jonacappelle/Embedded-Systems-II-Lab/README.md

# LAB: Embedded Systems II

## SOFTWARE

- [IMU](https://github.com/jonacappelle/Embedded-Systems-II-Lab/tree/master/Jona%20-%20IMU%20and%20Main%20PCB/Embedded_II_ICM_20948)
- [Game](https://github.com/jonacappelle/Embedded-Systems-II-Lab/tree/master/Niels%20-%20Code%20spel/SLSTK3400A_blink)
- [LoRa](https://github.com/jonacappelle/Embedded-Systems-II-Lab/tree/master/Pieter%20-%20Connectivity%20and%20Visualisation)

## HARDWARE

[Main board](https://github.com/jonacappelle/Embedded-Systems-II-Lab/tree/master/Jona%20-%20IMU%20and%20Main%20PCB/EFM32_ICM20948_PCB)  
[Energy harvesting](https://github.com/jonacappelle/Embedded-Systems-II-Lab/tree/master/Daan%20-%20VoedingDesign%20PCB/schema_pcb)

### MAIN BOARD: µC + Compass + LoRa

<p align="center">
  
</p>
<p align="center">
  
</p>

### POWER BOARD

<p align="center">
  
</p>
<p align="center">
  
</p>
