jonacappelle/Embedded-Systems-II-Lab/Daan - VoedingDesign PCB/EnergieBerekeningen.xlsx

Berekening voor 3 uur actief per dag |  |  | Bij zenden
 | IMU | LDO (IMU) | RFID (zenden) | LoRa (zenden) | EFM32 | 2x 7-segment displays | 4x Backlight LED's | Verliezen bij andere componenten
Stroomverbruik (mA) | 3.11 | 0.001 | 20 | 38.9 | 3.5 | 2 x 7 x 20 mA = 280 mA | 4 x 20 mA | 15
Werkspanning (V) | 1.8 | 1.5 | 3.3 | 3.3 | 3.3 | 2 | 3 | 3.3 |  | Veronderstellingen voor 3 uur spel per dag:
Vermogen verbruik (mW) | 5.598 | 0.0015 | 66 | 128.37 | 11.55 | 560 | 4 x 60 mW | 50 |  | 30 spelletjes in 3 uur gespeeld: 6 min per spel inclusief aanmelden
Tijd actief per dag (uur) | 3 | 3 | 30x0,033 | 0.000277 | 3 | 0.17 | 2.5 | 3 |  | 2x highscore in top drie verbroken per 3u --> tijd om te zenden 5 min per highscore
Tijd actief per dag (seconden) | 10800 | 10800 | 3600 | 1 | 10800 | 600 | 9000 | 10800 |  | 7 segment display 30 x 20 seconden aan op flikker (om de seconde flikkeren) stand (5 seconden aan om duidelijk te maken dat kaart gelezen moeten worden, 5 seconden aan voor score)
Energie verbruik (J) | 60.458 | 0.016 | 237.600 | 0.128 | 124.740 | 336.000 | 540.000 | 540.000 |  | gedurende de spel tijd (2,5 u): slechts 1 backlight per keer aan
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
