jonacappelle/Embedded-Systems-II-Lab/Daan - VoedingDesign PCB/aanwezigeComponentenOpSchool/90715364_145681366821309_824279871361384448_n.png

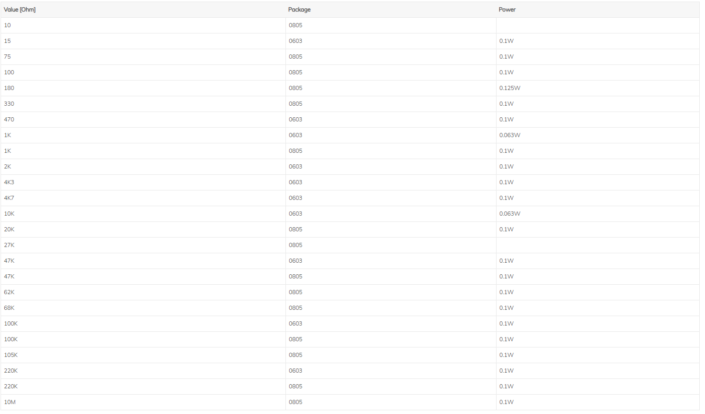
Daan - VoedingDesign PCB/aanwezigeComponentenOpSchool/90715364_145681366821309_824279871361384448_n.png
