jonacappelle/Embedded-Systems-II-Lab/Daan - VoedingDesign PCB/aanwezigeComponentenOpSchool/90789569_214061636350394_7333743442029182976_n.png

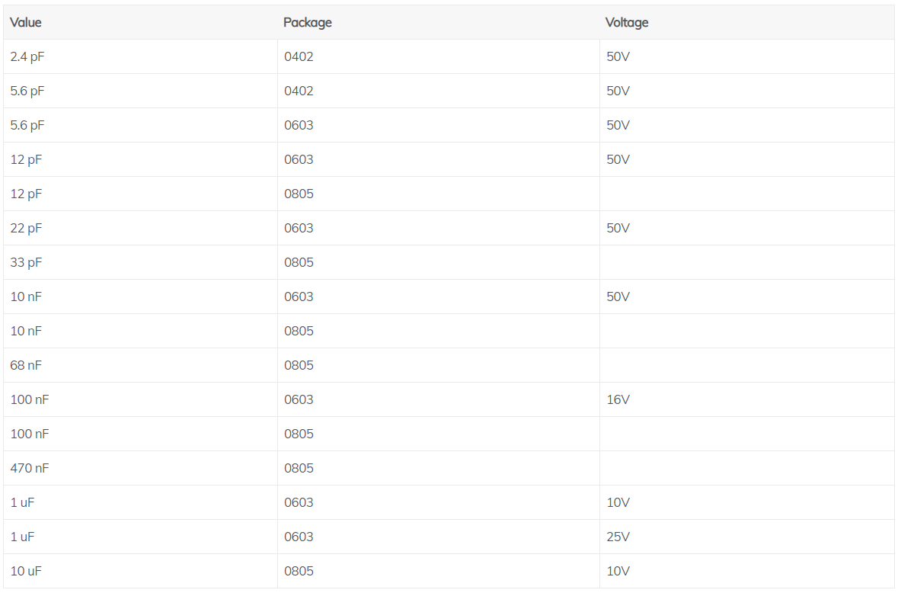
Daan - VoedingDesign PCB/aanwezigeComponentenOpSchool/90789569_214061636350394_7333743442029182976_n.png
