jonacappelle/Embedded-Systems-II-Lab/Info/Main_PCB/Embedded_II_MAIN_BOARD_BOM.txt

------------------------------------------------
Team Turn Table BOM Main PCB: Kompas + uC + LoRa
------------------------------------------------
Dit is het minimaal aantal nodige componenten.
Best enkele extras voorzien a.u.b.
------------------------------------------------

Qty Value                   Device                     Package                    Parts                                                                               Description                                                                                                                     DESCRIPTION                                                                                                                     HEIGHT MANUFACTURER_NAME MANUFACTURER_PART_NUMBER MOUSER_PART_NUMBER   MOUSER_PRICE-STOCK                                                     PROD_ID     SPICEPREFIX TP_SIGNAL_NAME VALUE                  

-------------
 Capacitors
-------------
Op de campus:
9   100n                    CAP_CERAMIC0603            0603                       C22, C23, C26, C27, C28, C29, C33, C3, C7                                           Ceramic Capacitors                                                                                                                                                                                                                                                                                                                                                                                                                                                          
2   10n                     CAP_CERAMIC0603            0603                       C30, C31                                                                            Ceramic Capacitors                                                                                                                                                                                                                                                                                                                                                                                                                                                          
2   10u                     C-EUC0805K                 C0805K                     C2, C6                                                                              CAPACITOR, European symbol                                                                                                                                                                                                                                                                                                                                                                                                C                                                 
3   10u                     CAP_CERAMIC0603            0603                       C1, C24, C25                                                                        Ceramic Capacitors                                                                                                                                                                                                                                                                                                                                                                                                                                                          
2   12p                     CAP_CERAMIC0603            0603                       C36, C37                                                                            Ceramic Capacitors                                                                                                                                                                                                                                                                                                                                                                                                                                                          
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
1   1                       RESISTOR0603               0603                       R34                                                                                 Resistors                                                                                                                                                                                                                                                                                                                                                                                                                                                                   
1   100                     RESISTOR0603               0603                       R33                                                                                 Resistors                                                                                                                                                                                                                                                                                                                                                                                                                                                                   
1   1Meg                    RESISTOR0603               0603                       R6                                                                                  Resistors                                                                                                                                                                                                                                                                                                                                                                                                                                                                   

Bestellen:
1   12Meg                   RESISTOR0603               0603                       R29                                                                                 Resistors                                                                                                                                                                                                                                                                                                                                                                                                                                                                   
https://www.mouser.be/ProductDetail/Yageo/AF0603JR-0712ML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

----------------
Microcontroller
----------------
1   IC2                     EFM32HG322F64G-C -QFP48R 
https://www.mouser.be/ProductDetail/Silicon-Labs/EFM32HG322F64G-C-QFP48R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

----------
 Mosfets
----------
3   20V/0.2A/8MHz/1.2Ω/1Vth MOSFET-NCH-RE1C002UN       SOT-416FL                  Q1, Q6, Q8                                                                          N-channel MOSFETs                                                                                                                                                                                                                                                                                                                                                                                             TRANS_14399                            20V/0.2A/8MHz/1.2Ω/1Vth
https://www.mouser.be/ProductDetail/ROHM-Semiconductor/RE1C002UNTCL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

-----------
 Kompas + accelerometer
-----------
1	ICM20948
https://www.mouser.be/ProductDetail/TDK-InvenSense/ICM-20948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

----------
 Ferriet
----------
1   74279266                74279266                   BEADC1608X100N             FB1                                                                                 WE-CBF Ferrite Bead 0603 1000Ohm 200mA Wurth WE-CBF Series +/-25% Ferrite Multilayer SMD Inductor, 0603 Case, 200mA dc 600m Rdc WE-CBF Ferrite Bead 0603 1000Ohm 200mA Wurth WE-CBF Series +/-25% Ferrite Multilayer SMD Inductor, 0603 Case, 200mA dc 600m Rdc 1mm    Wurth Elektronik  74279266                 710-74279266         https://www.mouser.com/Search/Refine.aspx?Keyword=710-74279266                                                                       
https://www.mouser.be/ProductDetail/Wurth-Elektronik/74279266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

----------
 Crystals
----------
1   FC-135_32.7680KA-A3     FC-135_32.7680KA-A3        FC135327680KAAG0           Y2                                                                                  Crystals 32.768KHz 20ppm 12.5pF -40C -85C                                                                                       Crystals 32.768KHz 20ppm 12.5pF -40C -85C                                                                                       0mm    Epson Timing      FC-135 32.7680KA-A3      732-FC135-32.76KAA3  https://www.mouser.com/Search/Refine.aspx?Keyword=732-FC135-32.76KAA3                                                                
1   ABM3B-24.000MHZ-B2-T    ABM3B-24.000MHZ-B2-T       ABM3B8000MHZ101UT          Y3                                                                                  Abracon 24MHz Crystal +/-20ppm SMD 5 x 3 x 1.1mm                                                                                Abracon 24MHz Crystal +/-20ppm SMD 5 x 3 x 1.1mm                                                                                1.1mm  ABRACON           ABM3B-24.000MHZ-B2-T     815-ABM3B-24-B2      https://www.mouser.com/Search/Refine.aspx?Keyword=815-ABM3B-24-B2                                                                    
https://www.mouser.be/ProductDetail/ABRACON/ABM3B-24000MHZ-B2-T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
https://www.mouser.be/ProductDetail/Epson-Timing/FC-135-327680KA-A3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

---------
 Button
---------
1   PTS815_SJK_250_SMTR_LFS PTS815_SJK_250_SMTR_LFS    PTS815SJK250SMTRLFS        S1                                                                                  Tactile Switches Tact Switch, 12 VDC, 50 mA, 4.2x3.2, 2.5mm H, 250gf, J leads                                                   Tactile Switches Tact Switch, 12 VDC, 50 mA, 4.2x3.2, 2.5mm H, 250gf, J leads                                                   2mm    C & K COMPONENTS  PTS815 SJK 250 SMTR LFS  611-PTS815SJK250SMTR https://www.mouser.com/Search/Refine.aspx?Keyword=611-PTS815SJK250SMTR                                                               
https://www.mouser.be/ProductDetail/CK/PTS815-SJK-250-SMTR-LFS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

---------
 LDO
---------
1   TPS7A0518PDBZR          TPS7A0518PDBZR             SOT95P237X112-3N           IC5                                                                                 1-A, ultra-low-IQ, 200-mA low-dropout (LDO) regulator in a small-sized package                                                  1-A, ultra-low-IQ, 200-mA low-dropout (LDO) regulator in a small-sized package                                                  1.12mm Texas Instruments TPS7A0518PDBZR           595-TPS7A0518PDBZR   https://www.mouser.com/Search/Refine.aspx?Keyword=595-TPS7A0518PDBZR                                                                 
https://www.mouser.be/ProductDetail/Texas-Instruments/TPS7A0518PDBZR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

--------
 Led
--------
1   Green/Blue              LED0805                    CHIPLED_0805               PWR_LED                                                                             LED                                                                                                                                                                                                                                                                                                                                                                                                                                                                         

--------
 LoRa
--------
Waarschijnlijk op de campus?
1   RN2483 LoRa module	
1   ANTENNA868              ANTENNA868                 CERAMIC-ANTENNA            U$2                                                                                                                                                                                                                                                                                                                                                                                                                                                                                                                                                             
1   WE-MK_0603_744786118    WE-MK_0603_744786118       WE-MK_0603                 L1                                                                                                                                                                                                                                                                                                                                                                                                                                                                                                                                                              
2   Caps bij LoRa module    C-EUC0603K                 C0603K                     C4, C5                                                                              CAPACITOR, European symbol
