jonacappelle/Embedded-Systems-II-Lab/Info/Main_PCB/Embedded_II_MAIN_BOARD.pdf

# IMU

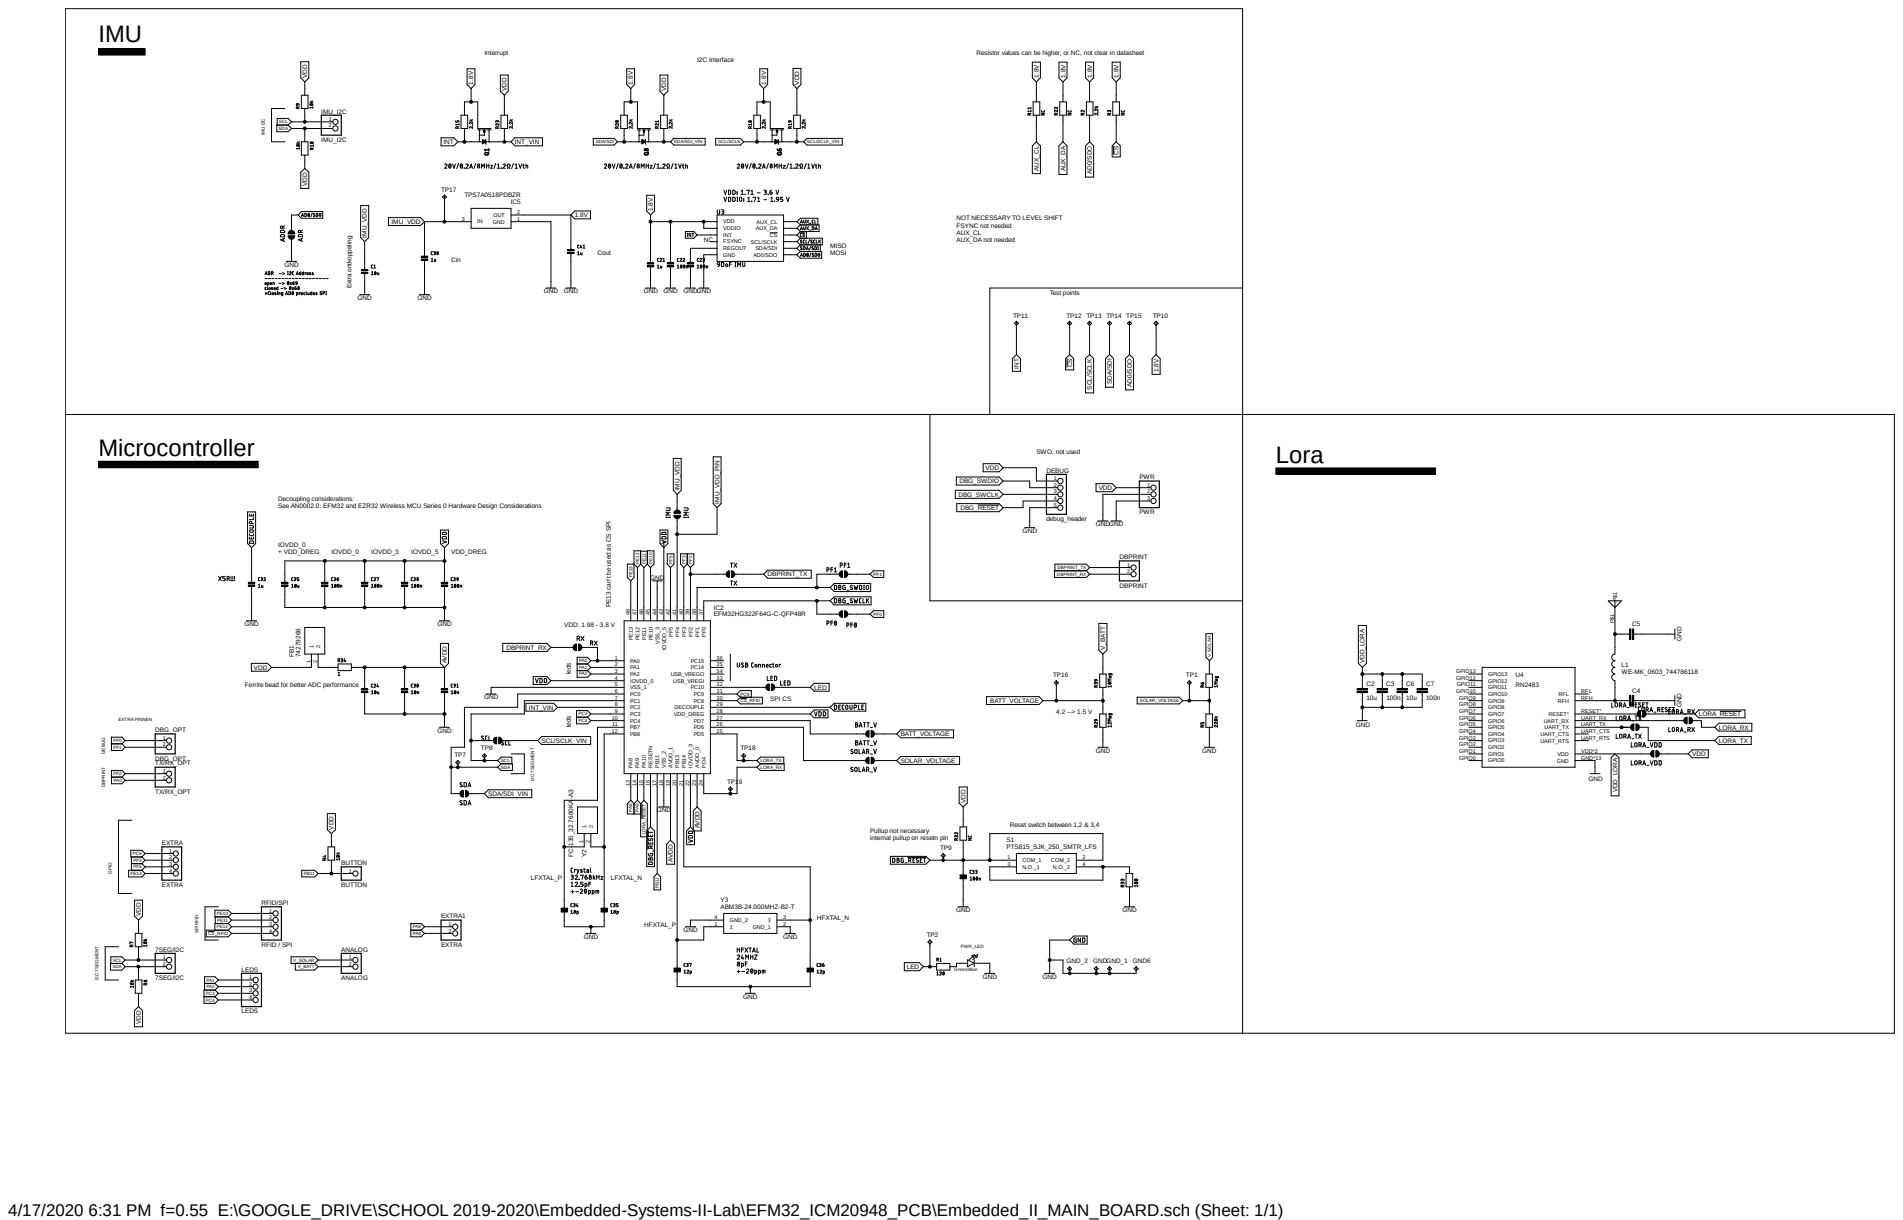
[picture p68: page 1]

Resistor values can be higher, or NC, not clear in datasheet

NOT NECESSARY TO LEVEL SHIFT
FSYNC not needed
AUX_CL

CoutPE¹³ can't be used as CS SPI

VDD VDD

Decoupling considerations:
See AN0002.0: EFM32 and EZR32 Wireless MCU Series 0 Hardware Design Considerations

Ferrite bead for better ADC performance

Pullup not necessary
internal pullup on resetn pin

4/17/2020 6:31 PM f=0.55 E:\GOOGLE_DRIVE\SCHOOL 2019-2020\Embedded-Systems-II-Lab\EFM32_ICM20948_PCB\Embedded_II_MAIN_BOARD.sch (Sheet: 1/1)
