jonacappelle/Embedded-Systems-II-Lab/Pieter - Connectivity and Visualisation/LoRaWAN_EFM32-master_DRAMCO/DOC/Eagle/v4.0.pdf

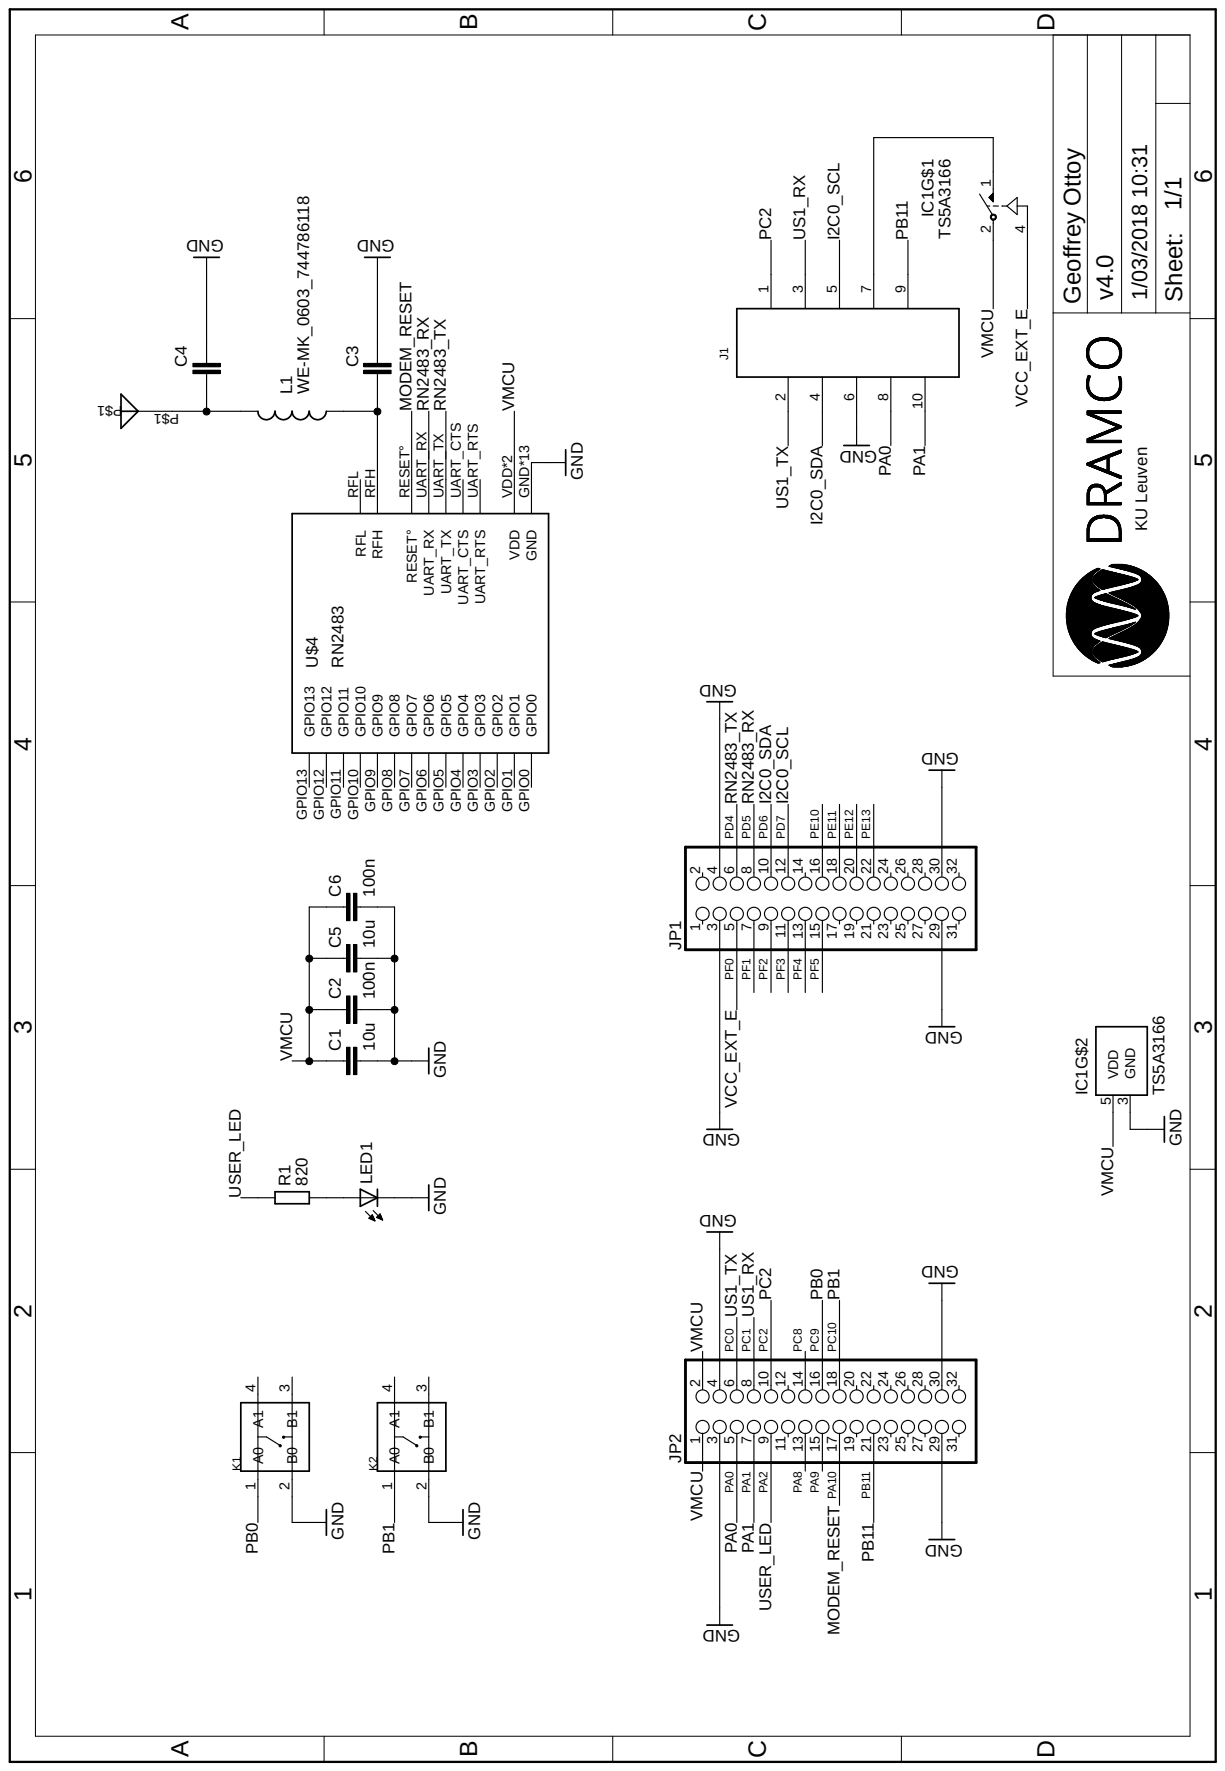
[picture p69: page 1]

P$1 P$1 L1 C5 C6 IC1G$1 4 1 2 IC1G$2 GND 3 VDD 5 VMCU VMCU VMCU VMCU VMCU VMCU PC0 PC1 PC2 PC2 PC8 PC9 PC10 PA0 PA0 PA1 PA1 PA2 PA8 PA9 PA10 PB11 PB11 PD4 PD5 PD6 PD7 PE10 PE11 PE12 PE13 PF0 PF1 PF2 PF3 PF4 PF5 v4.0 1/03/2018 10:31 1/1 Sheet: ABCD 1 2 3 4 5 6 ABCD 1 2 3 4 5 6

Geoffrey Ottoy KU Leuven 10u 100n GND RN2483 GND

GND GND WE-MK_0603_744786118 10u 100n TS5A3166 TS5A3166 GND I2C0_SDA I2C0_SCL PC2 PB0 PB1 PA0 PA1 PB11 MODEM_RESET RN2483_RX RN2483_TX RN2483_TX RN2483_RX MODEM_RESET I2C0_SCL I2C0_SDA US1_TX US1_RX US1_TX US1_RX PB0 PB1 USER_LED USER_LED VCC_EXT_E VCC_EXT_E C1 C2 GND GND*13 UART_TX UART_TX UART_RX UART_RX VDD VDD*2 RFH RFH RFL RFL RESET° RESET° U$4 UART_CTS UART_CTS UART_RTS UART_RTS GPIO0 GPIO0 GPIO1 GPIO1 GPIO2 GPIO2 GPIO3 GPIO3 GPIO4 GPIO4 GPIO5 GPIO5 GPIO6 GPIO6 GPIO7 GPIO7 GPIO8 GPIO8 GPIO9 GPIO9 GPIO10 GPIO10 GPIO11 GPIO11 GPIO12 GPIO12 GPIO13 GPIO13 JP21 2 3 4 5 6 7 8 9 10 11 12 13 14 15 16 17 18 19 20 21 22 23 24 25 26 27 28 29 30 31 32 JP11 2 3 4 5 6 7 8 9 10 11 12 13 14 15 16 17 18 19 20 21 22 23 24 25 26 27 28 29 30 31 32 J1 10 9 8 7 6 5 4 3 2 1 K1A0 1 A1 4 B0 2 B1 3 K2A0 1 A1 4 B0 2 B1 3 R1LED1 C4 C3

GND GND GND 820 GND
