jonacappelle/Embedded-Systems-II-Lab/Daan - VoedingDesign PCB/schema_pcb/EnergyHarvestingBestukking.pdf

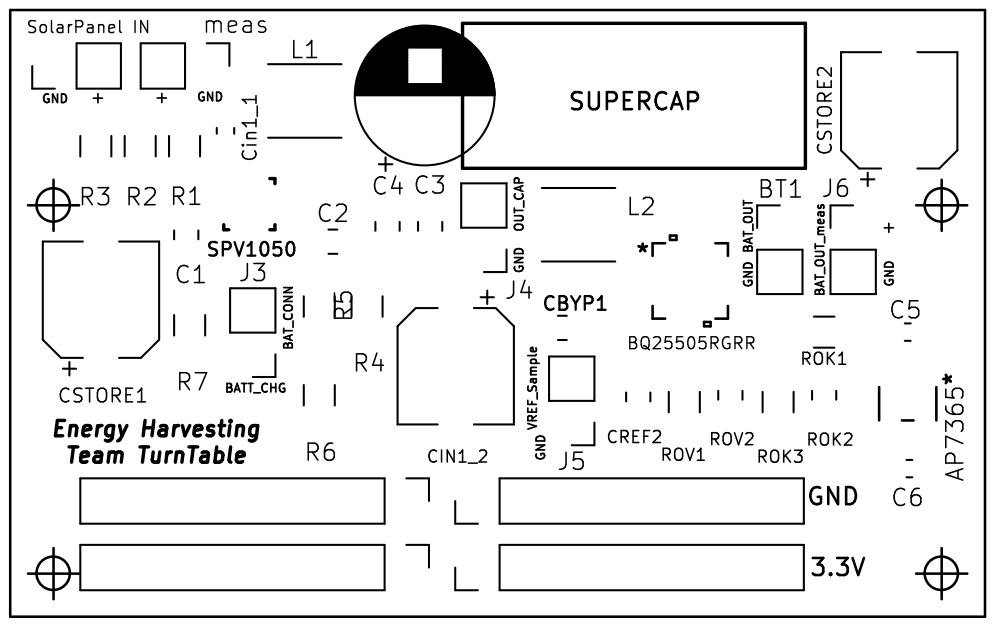
[picture p70: page 1]

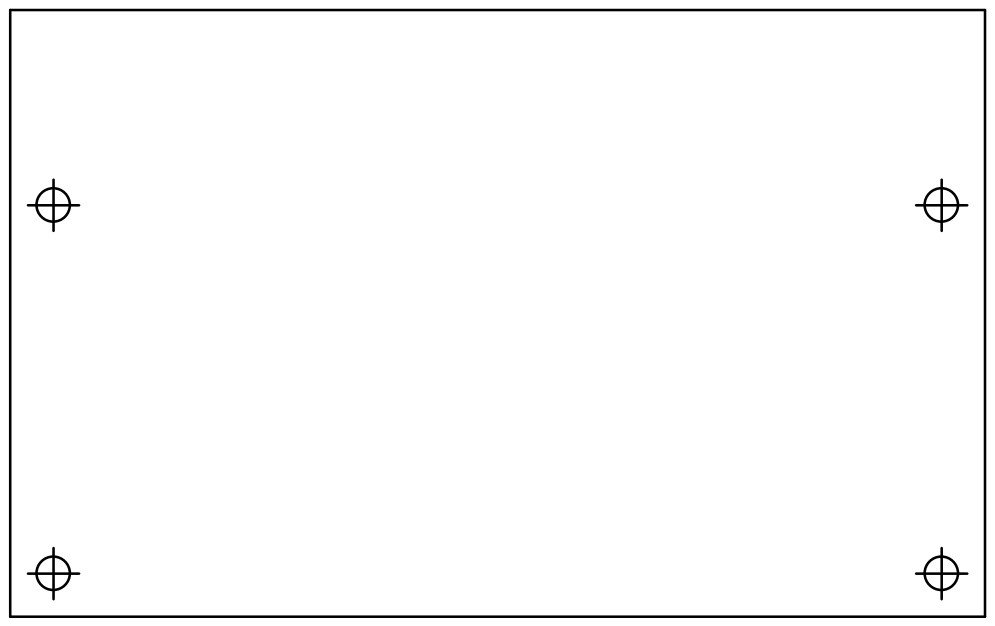
[picture p71: page 2]

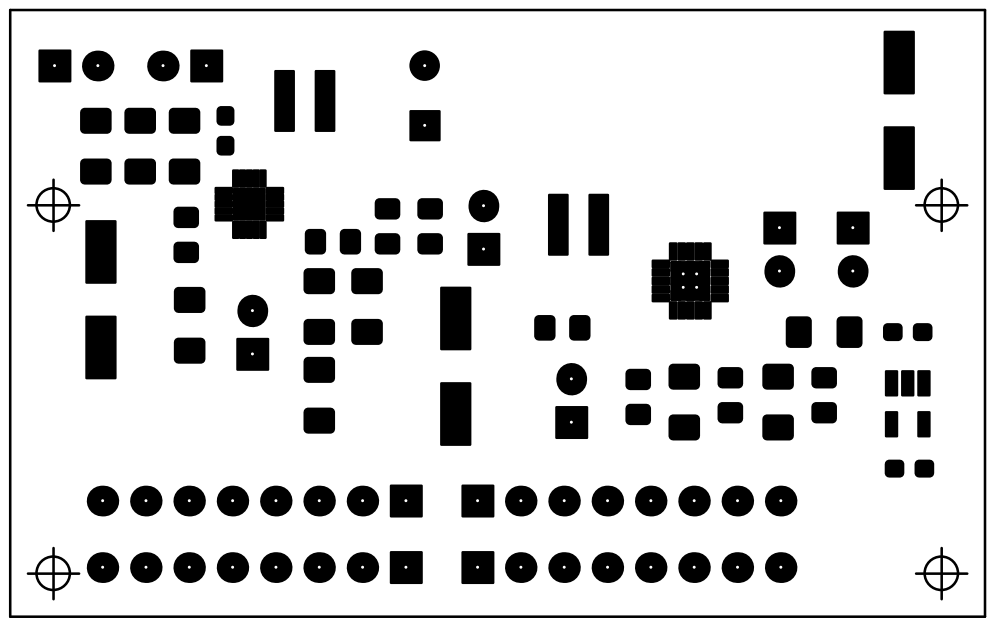
[picture p72: page 3]

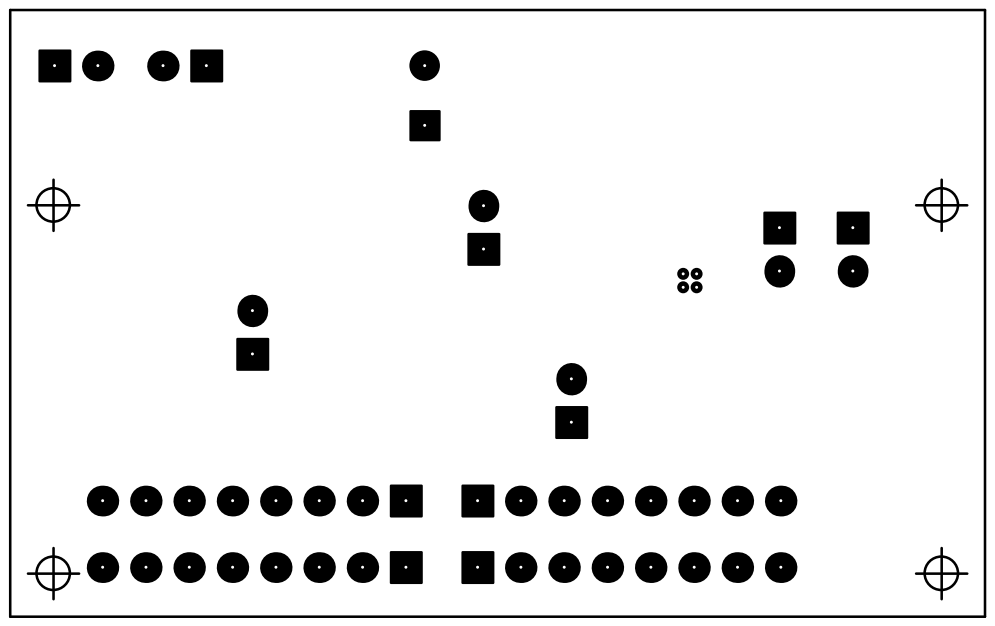
[picture p73: page 4]
