jonacappelle/Embedded-Systems-II-Lab/Daan - VoedingDesign PCB/schema_pcb/BestukkingInfo/EnergyHarvestingPCB/BestukkingEnergyHarvesting.pdf

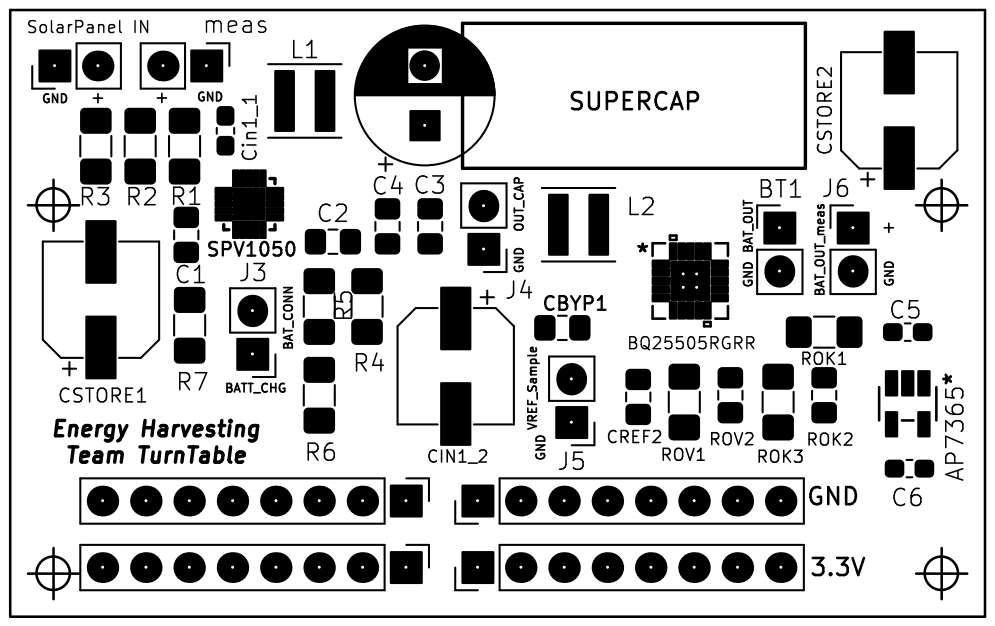
[picture p74: page 1]
