jonacappelle/Embedded-Systems-II-Lab/Info/EnergyHarvestingPCB/Schema.pdf

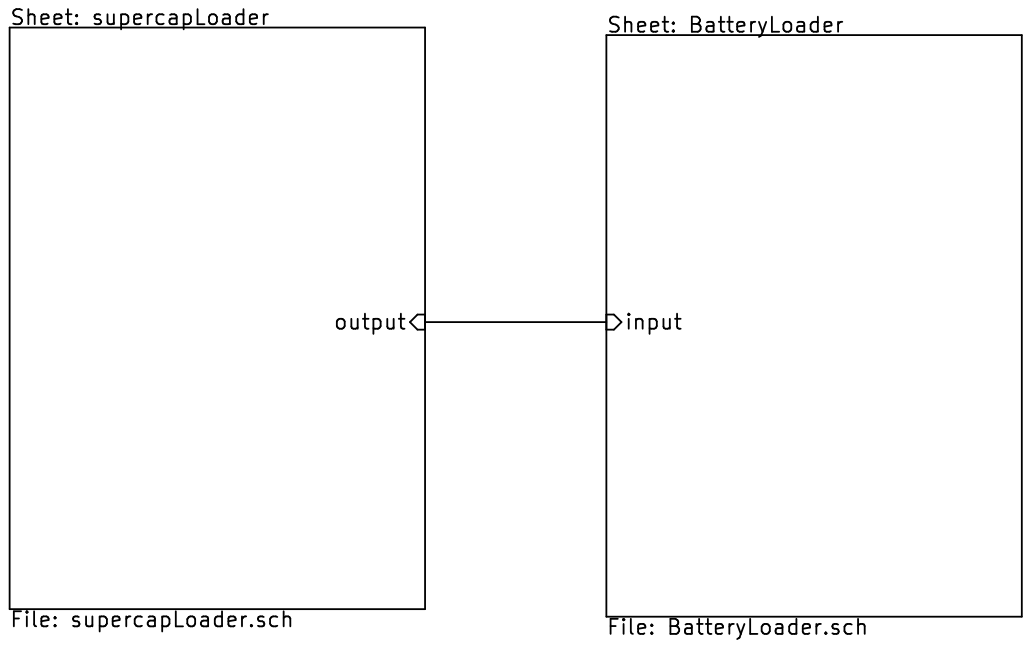
[picture p75: page 1]

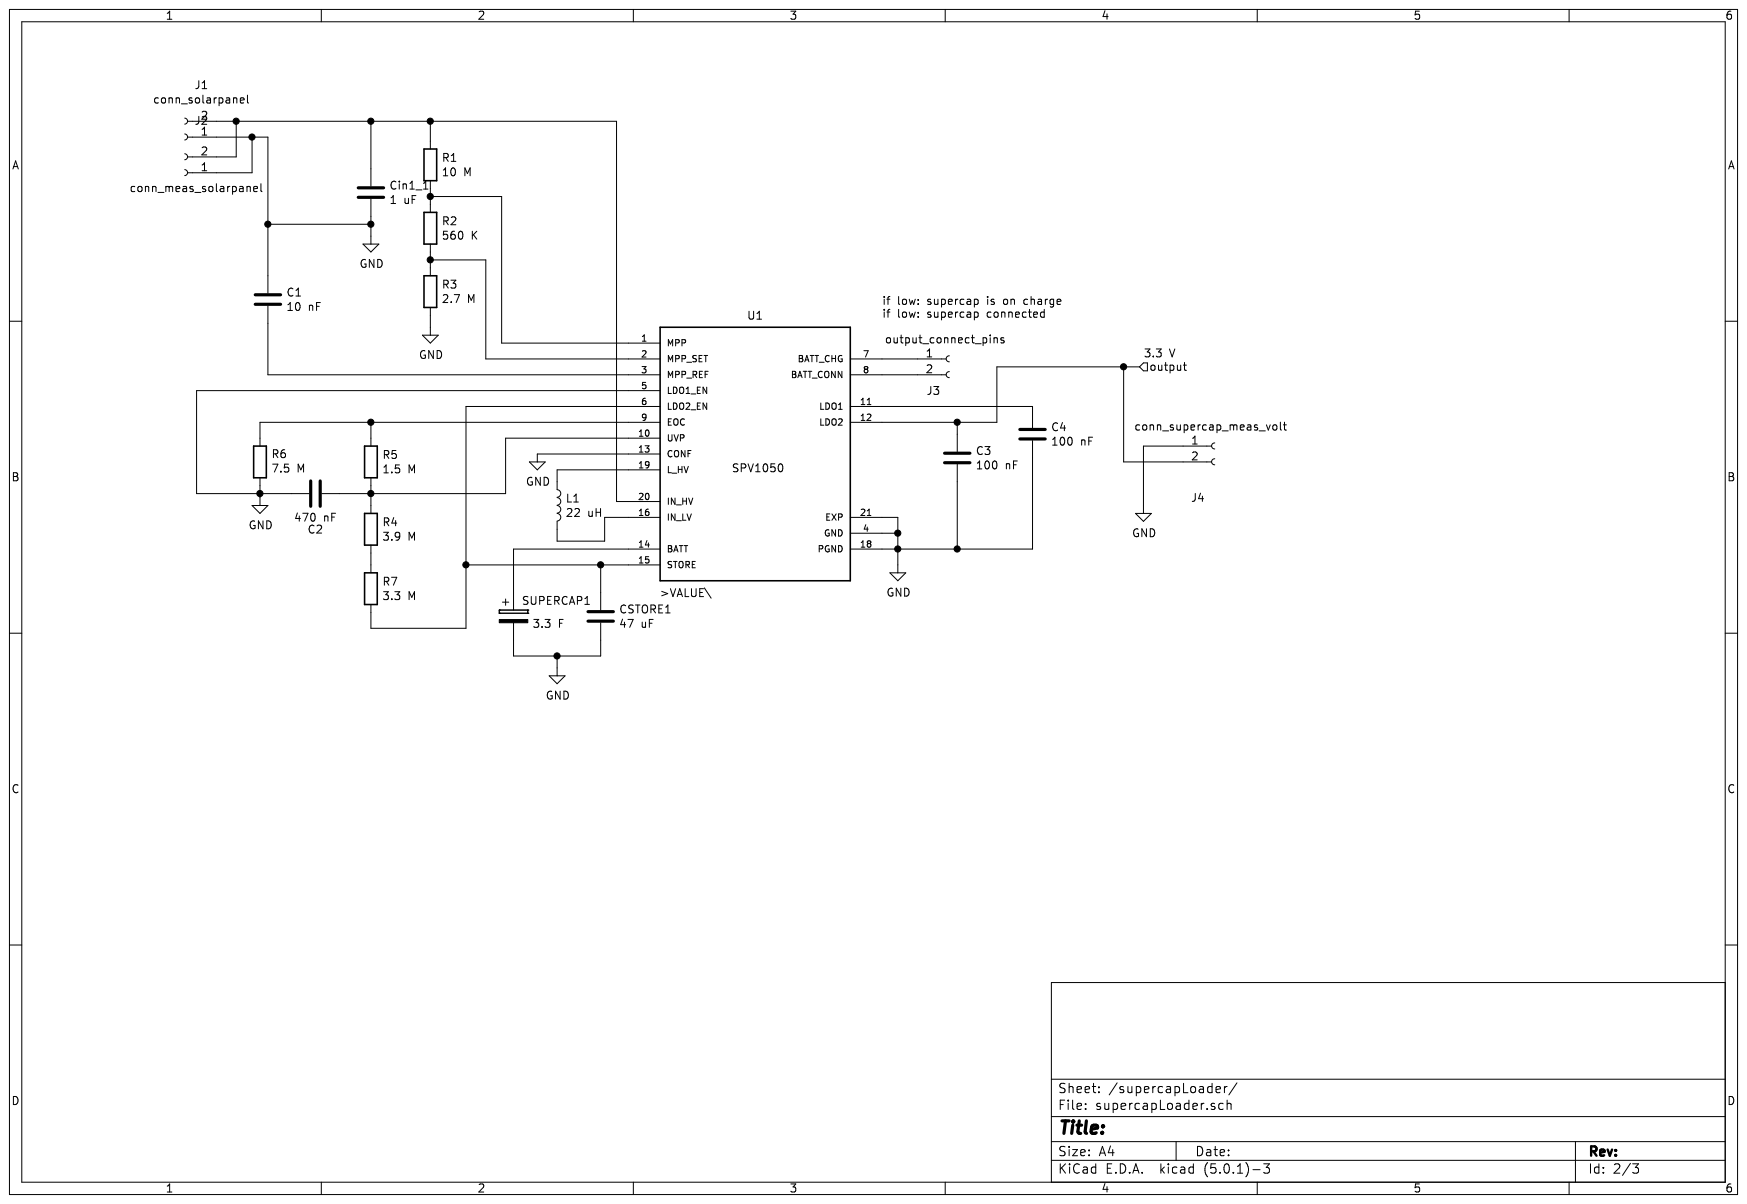
[picture p76: page 2]

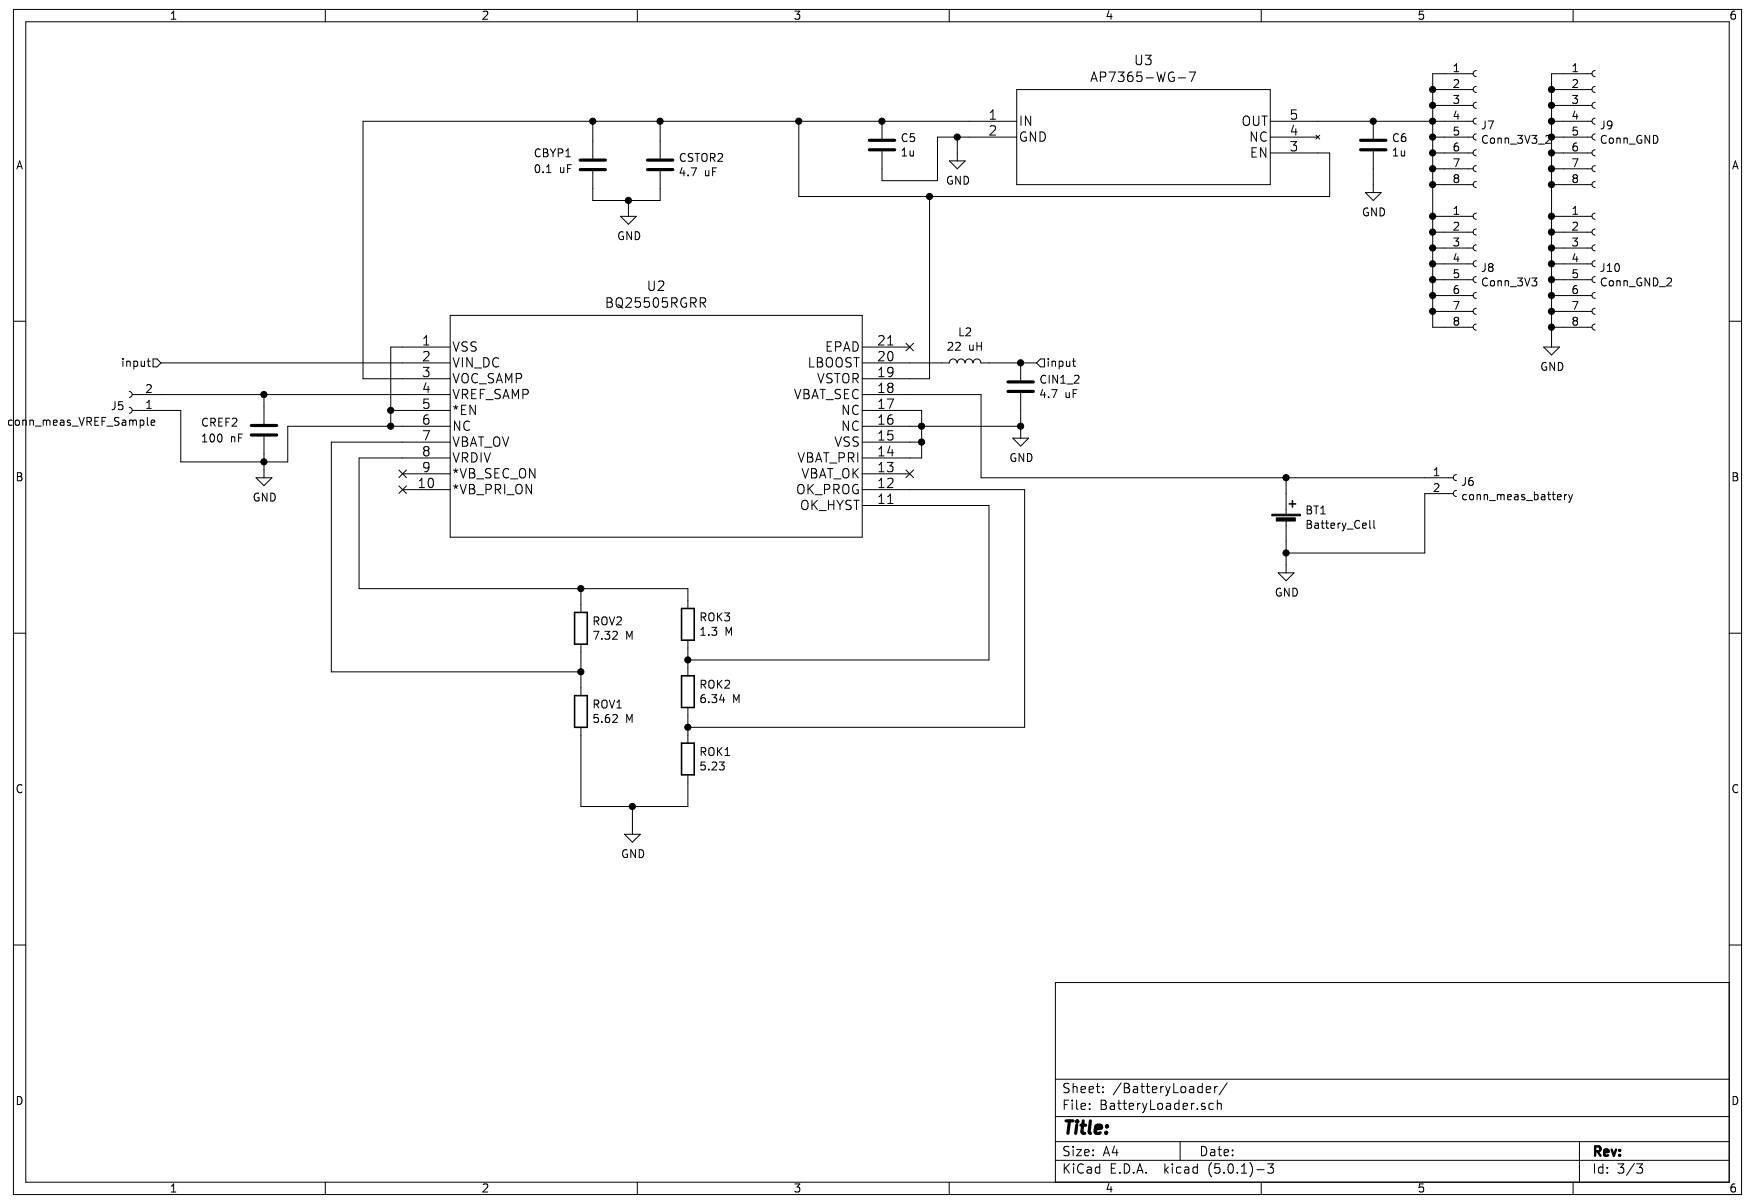
[picture p77: page 3]
