jonacappelle/Embedded-Systems-II-Lab/Daan - VoedingDesign PCB/schema_pcb/schema_pcb.kicad_pcb

## KiCad design Daan - VoedingDesign PCB/schema_pcb/schema_pcb.kicad_pcb (2020-04-17)

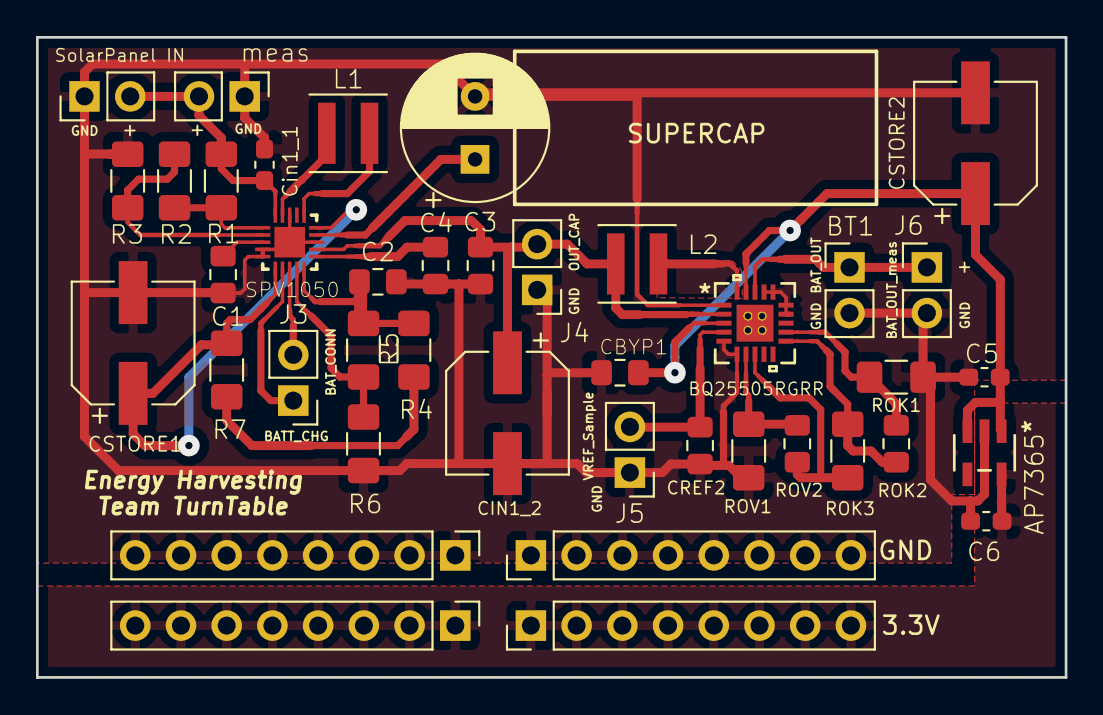
[picture p80: board schema_pcb.kicad_pcb from above]

Board: 2 copper layers, 57.2 x 35.6 mm, 37 parts (0 on the bottom side), 24 nets.

Parts:
3.3V: Conn_3V3_2; PinHeader_1x08_P2.54mm_Vertical
BT1: Battery_Cell; PinHeader_1x02_P2.54mm_Vertical
C1: 10 nF; C_0805_2012Metric_Pad1.15x1.40mm_HandSolder
C2: 470 nF; C_0805_2012Metric_Pad1.15x1.40mm_HandSolder
C3, C4: 100 nF; C_0805_2012Metric_Pad1.15x1.40mm_HandSolder
C5, C6: 1u; C_0603_1608Metric_Pad1.05x0.95mm_HandSolder
CBYP1: 0.1 uF; C_0805_2012Metric_Pad1.15x1.40mm_HandSolder
CIN1_2: 4.7 uF; CP_Elec_6.3x5.3
CREF2: 100 nF; C_0805_2012Metric_Pad1.15x1.40mm_HandSolder
CSTORE1: 47 uF; CP_Elec_6.3x5.3
CSTORE2: 4.7 uF; CP_Elec_6.3x5.3
Cin1_1: 1 uF; C_0603_1608Metric_Pad1.05x0.95mm_HandSolder
GND: Conn_GND; PinHeader_1x08_P2.54mm_Vertical
J3: output_connect_pins; PinHeader_1x02_P2.54mm_Vertical
J4: conn_supercap_meas_volt; PinHeader_1x02_P2.54mm_Vertical
J5: conn_meas_VREF_Sample; PinHeader_1x02_P2.54mm_Vertical
J6: conn_meas_battery; PinHeader_1x02_P2.54mm_Vertical
L1, L2: 22 uH; L_Coilcraft_XxL4040
R1: 10 M; R_1206_3216Metric_Pad1.42x1.75mm_HandSolder
R2: 560 K; R_1206_3216Metric_Pad1.42x1.75mm_HandSolder
R3: 2.7 M; R_1206_3216Metric_Pad1.42x1.75mm_HandSolder
R4: 3.9 M; R_1206_3216Metric_Pad1.42x1.75mm_HandSolder
R5: 1.5 M; R_1206_3216Metric_Pad1.42x1.75mm_HandSolder
R6: 7.5 M; R_1206_3216Metric_Pad1.42x1.75mm_HandSolder
R7: 3.3 M; R_1206_3216Metric_Pad1.42x1.75mm_HandSolder
ROK1: 5.23; R_1206_3216Metric_Pad1.42x1.75mm_HandSolder
ROK2: 6.34 M; R_0805_2012Metric_Pad1.15x1.40mm_HandSolder
ROK3: 1.3 M; R_1206_3216Metric_Pad1.42x1.75mm_HandSolder
ROV1: 5.62 M; R_1206_3216Metric_Pad1.42x1.75mm_HandSolder
ROV2: 7.32 M; R_0805_2012Metric_Pad1.15x1.40mm_HandSolder
SPV1050: SPV1050TTR; QFN40P300X300X100-21N
SUPERCAP: 3.3 F; CP_Radial_D8.0mm_P3.50mm
SolarPanel IN: conn_solarpanel; PinHeader_1x02_P2.54mm_Vertical
meas: conn_meas_solarpanel; PinHeader_1x02_P2.54mm_Vertical

Connections:
/BatteryLoader/input: C3.1, CIN1_2.1, J4.2, L2.2, SPV1050.12
GND: BT1.2, C1.1, C2.2, C3.2, C4.2, C5.2, C6.2, CBYP1.2, CIN1_2.2, CREF2.2, CSTORE1.2, CSTORE2.2, Cin1_1.2, GND.1, GND.2, GND.3, GND.4, GND.5, GND.6, GND.7, GND.8, J4.1, J5.1, J6.2, R3.2, R6.1, ROK1.2, ROV1.2, SPV1050.4, SPV1050.5, SPV1050.13, SPV1050.18, SPV1050.21, SUPERCAP.2, SolarPanel IN.1, meas.1
unnamed: BT1.1, J6.1
unnamed: C1.2, SPV1050.3
unnamed: C2.1, R4.1, R5.2, SPV1050.10
unnamed: C4.1, SPV1050.11
unnamed: C5.1, CBYP1.1, CSTORE2.1
unnamed: 3.3V.1, 3.3V.2, 3.3V.3, 3.3V.4, 3.3V.5, 3.3V.6, 3.3V.7, 3.3V.8, C6.1
unnamed: CREF2.1, J5.2
unnamed: CSTORE1.1, R7.2, SPV1050.6, SPV1050.15
unnamed: Cin1_1.1, R1.1, SPV1050.20, SolarPanel IN.2, meas.2
unnamed: J3.1, SPV1050.7
unnamed: J3.2, SPV1050.8
unnamed: L1.1, SPV1050.19
unnamed: L1.2, SPV1050.16
unnamed: R1.2, R2.1, SPV1050.1
unnamed: R2.2, R3.1, SPV1050.2
unnamed: R4.2, R7.1
unnamed: R5.1, R6.2, SPV1050.9
unnamed: ROK1.1, ROK2.2
unnamed: ROK2.1, ROK3.2
unnamed: ROK3.1, ROV2.1
unnamed: ROV1.1, ROV2.2
unnamed: SPV1050.14, SUPERCAP.1
