jonacappelle/Embedded-Systems-II-Lab/Info/Main_PCB/Embedded_II_MAIN_BOARD.brd

## EAGLE design Info/Main_PCB/Embedded_II_MAIN_BOARD.brd (2020-04-17)

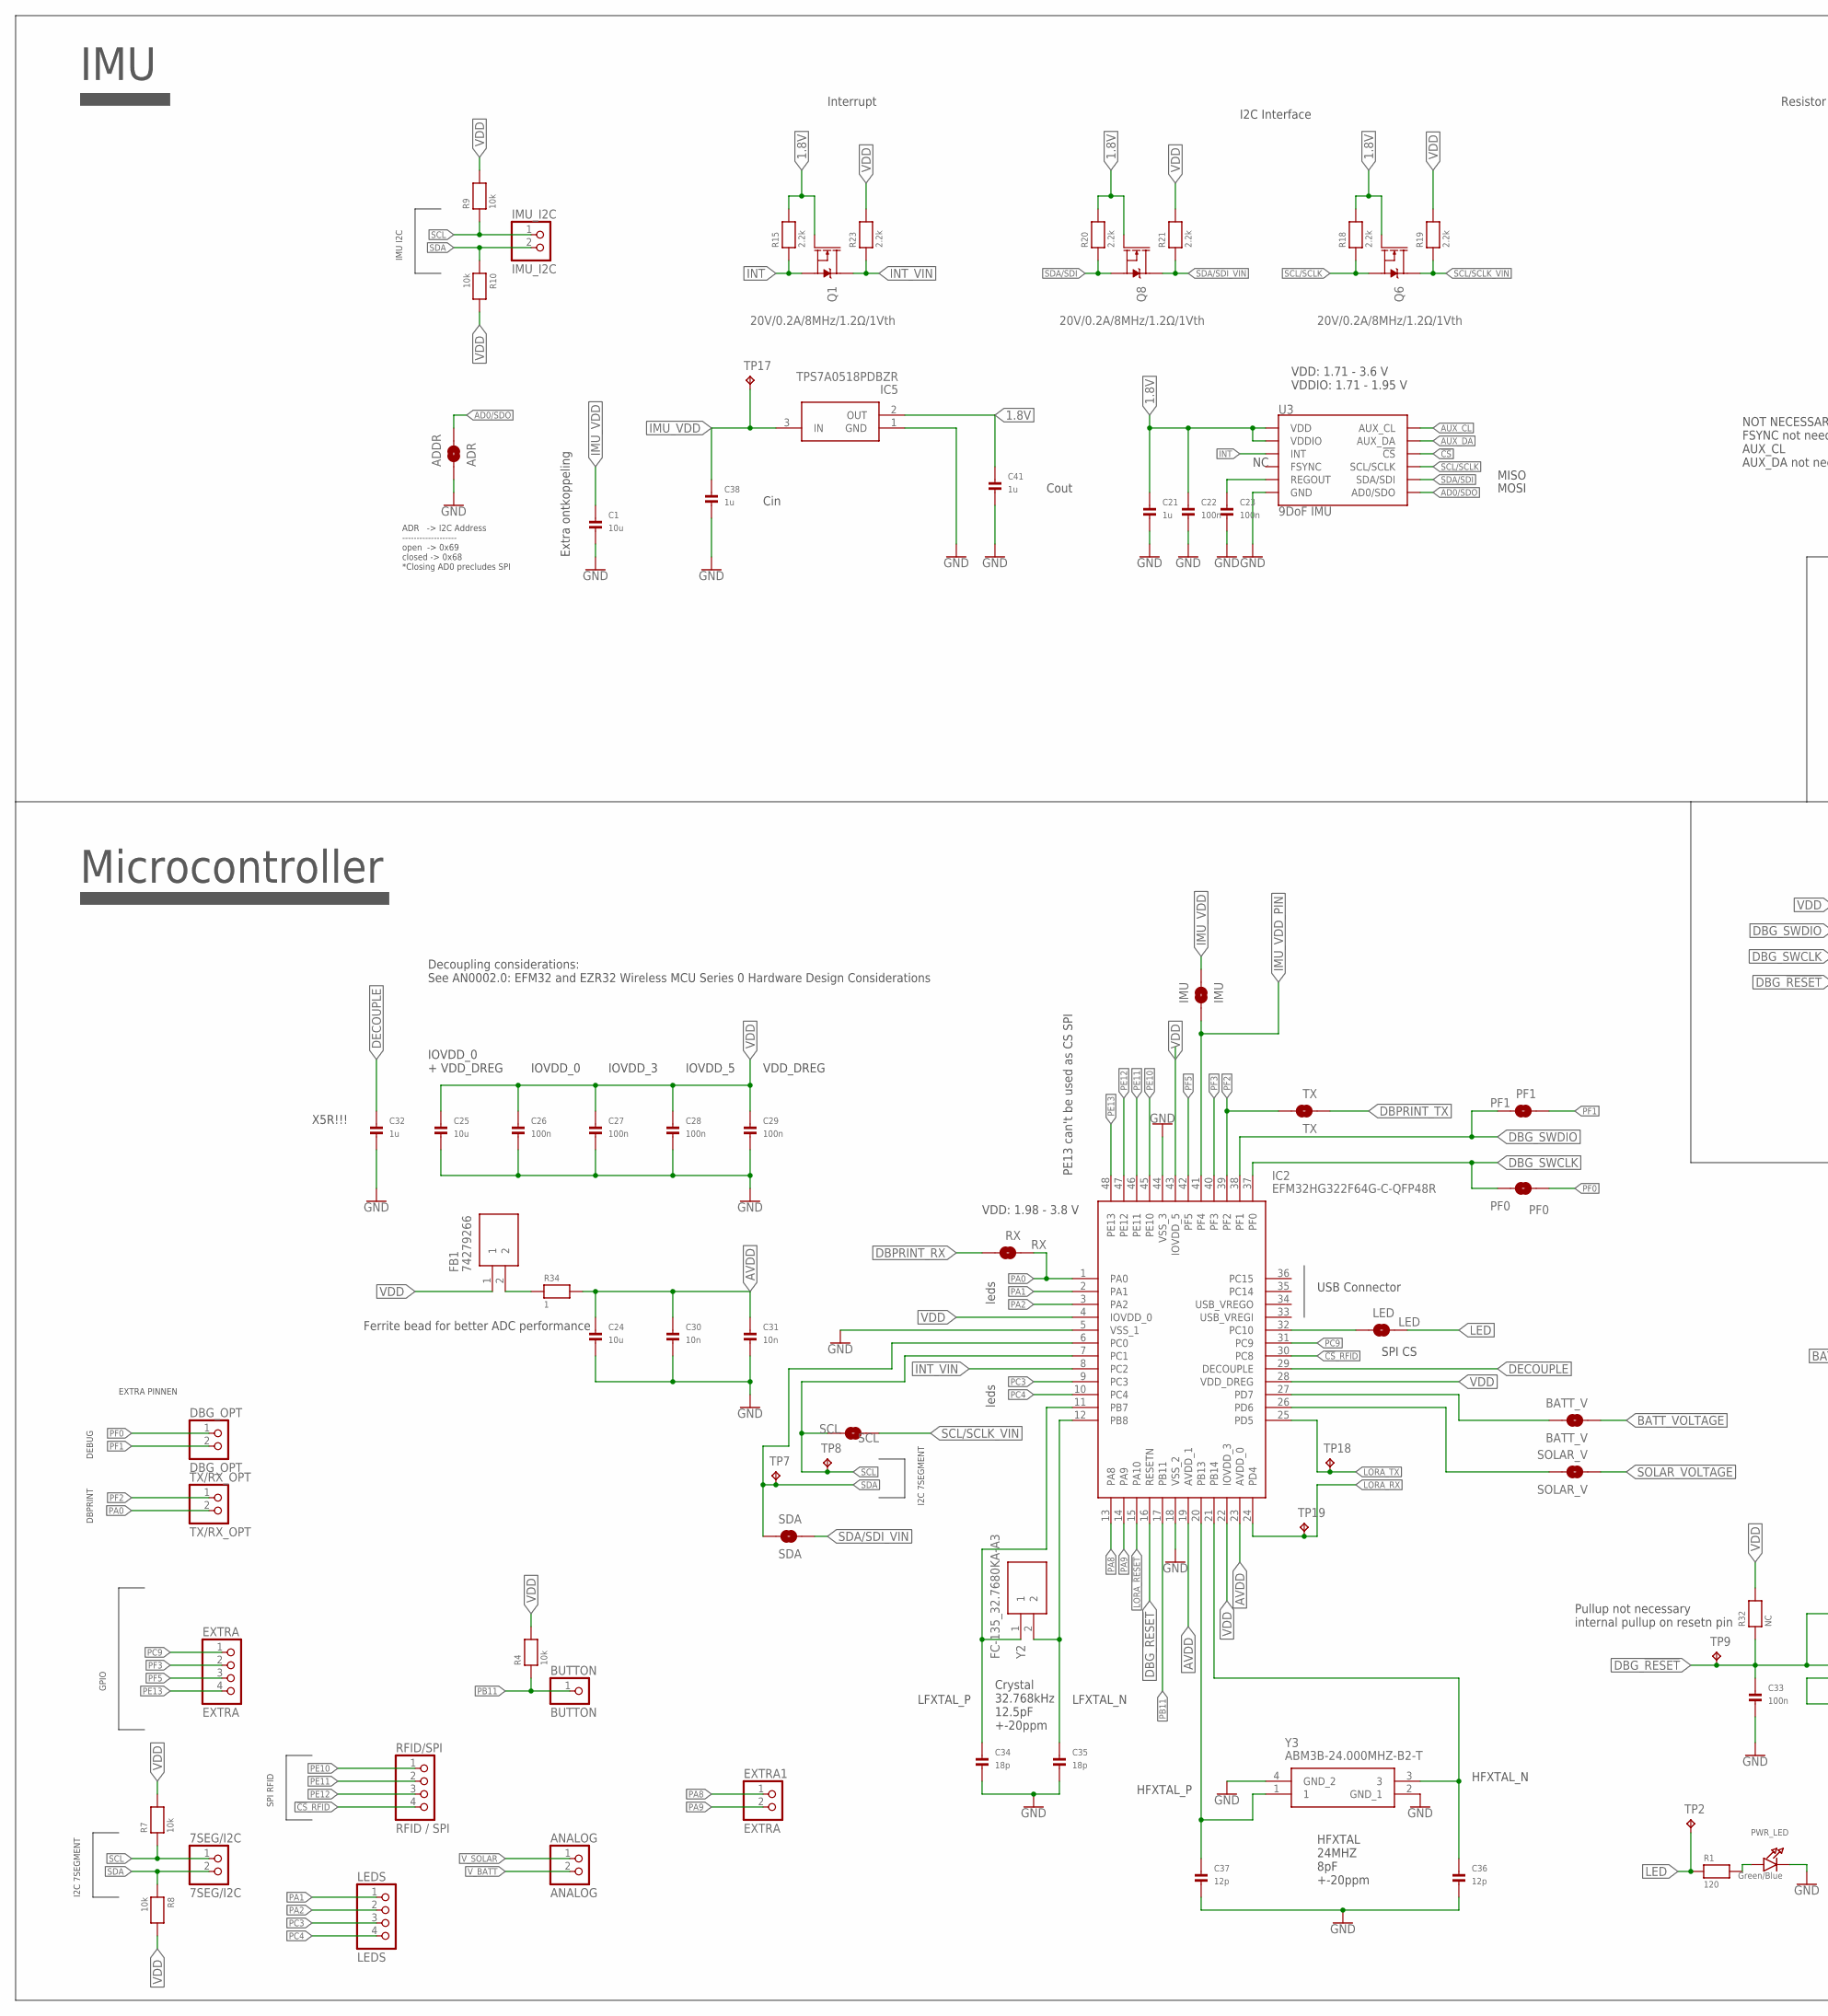
[picture p83: schematic Embedded_II_MAIN_BOARD.sch, part in row 1, column 1]

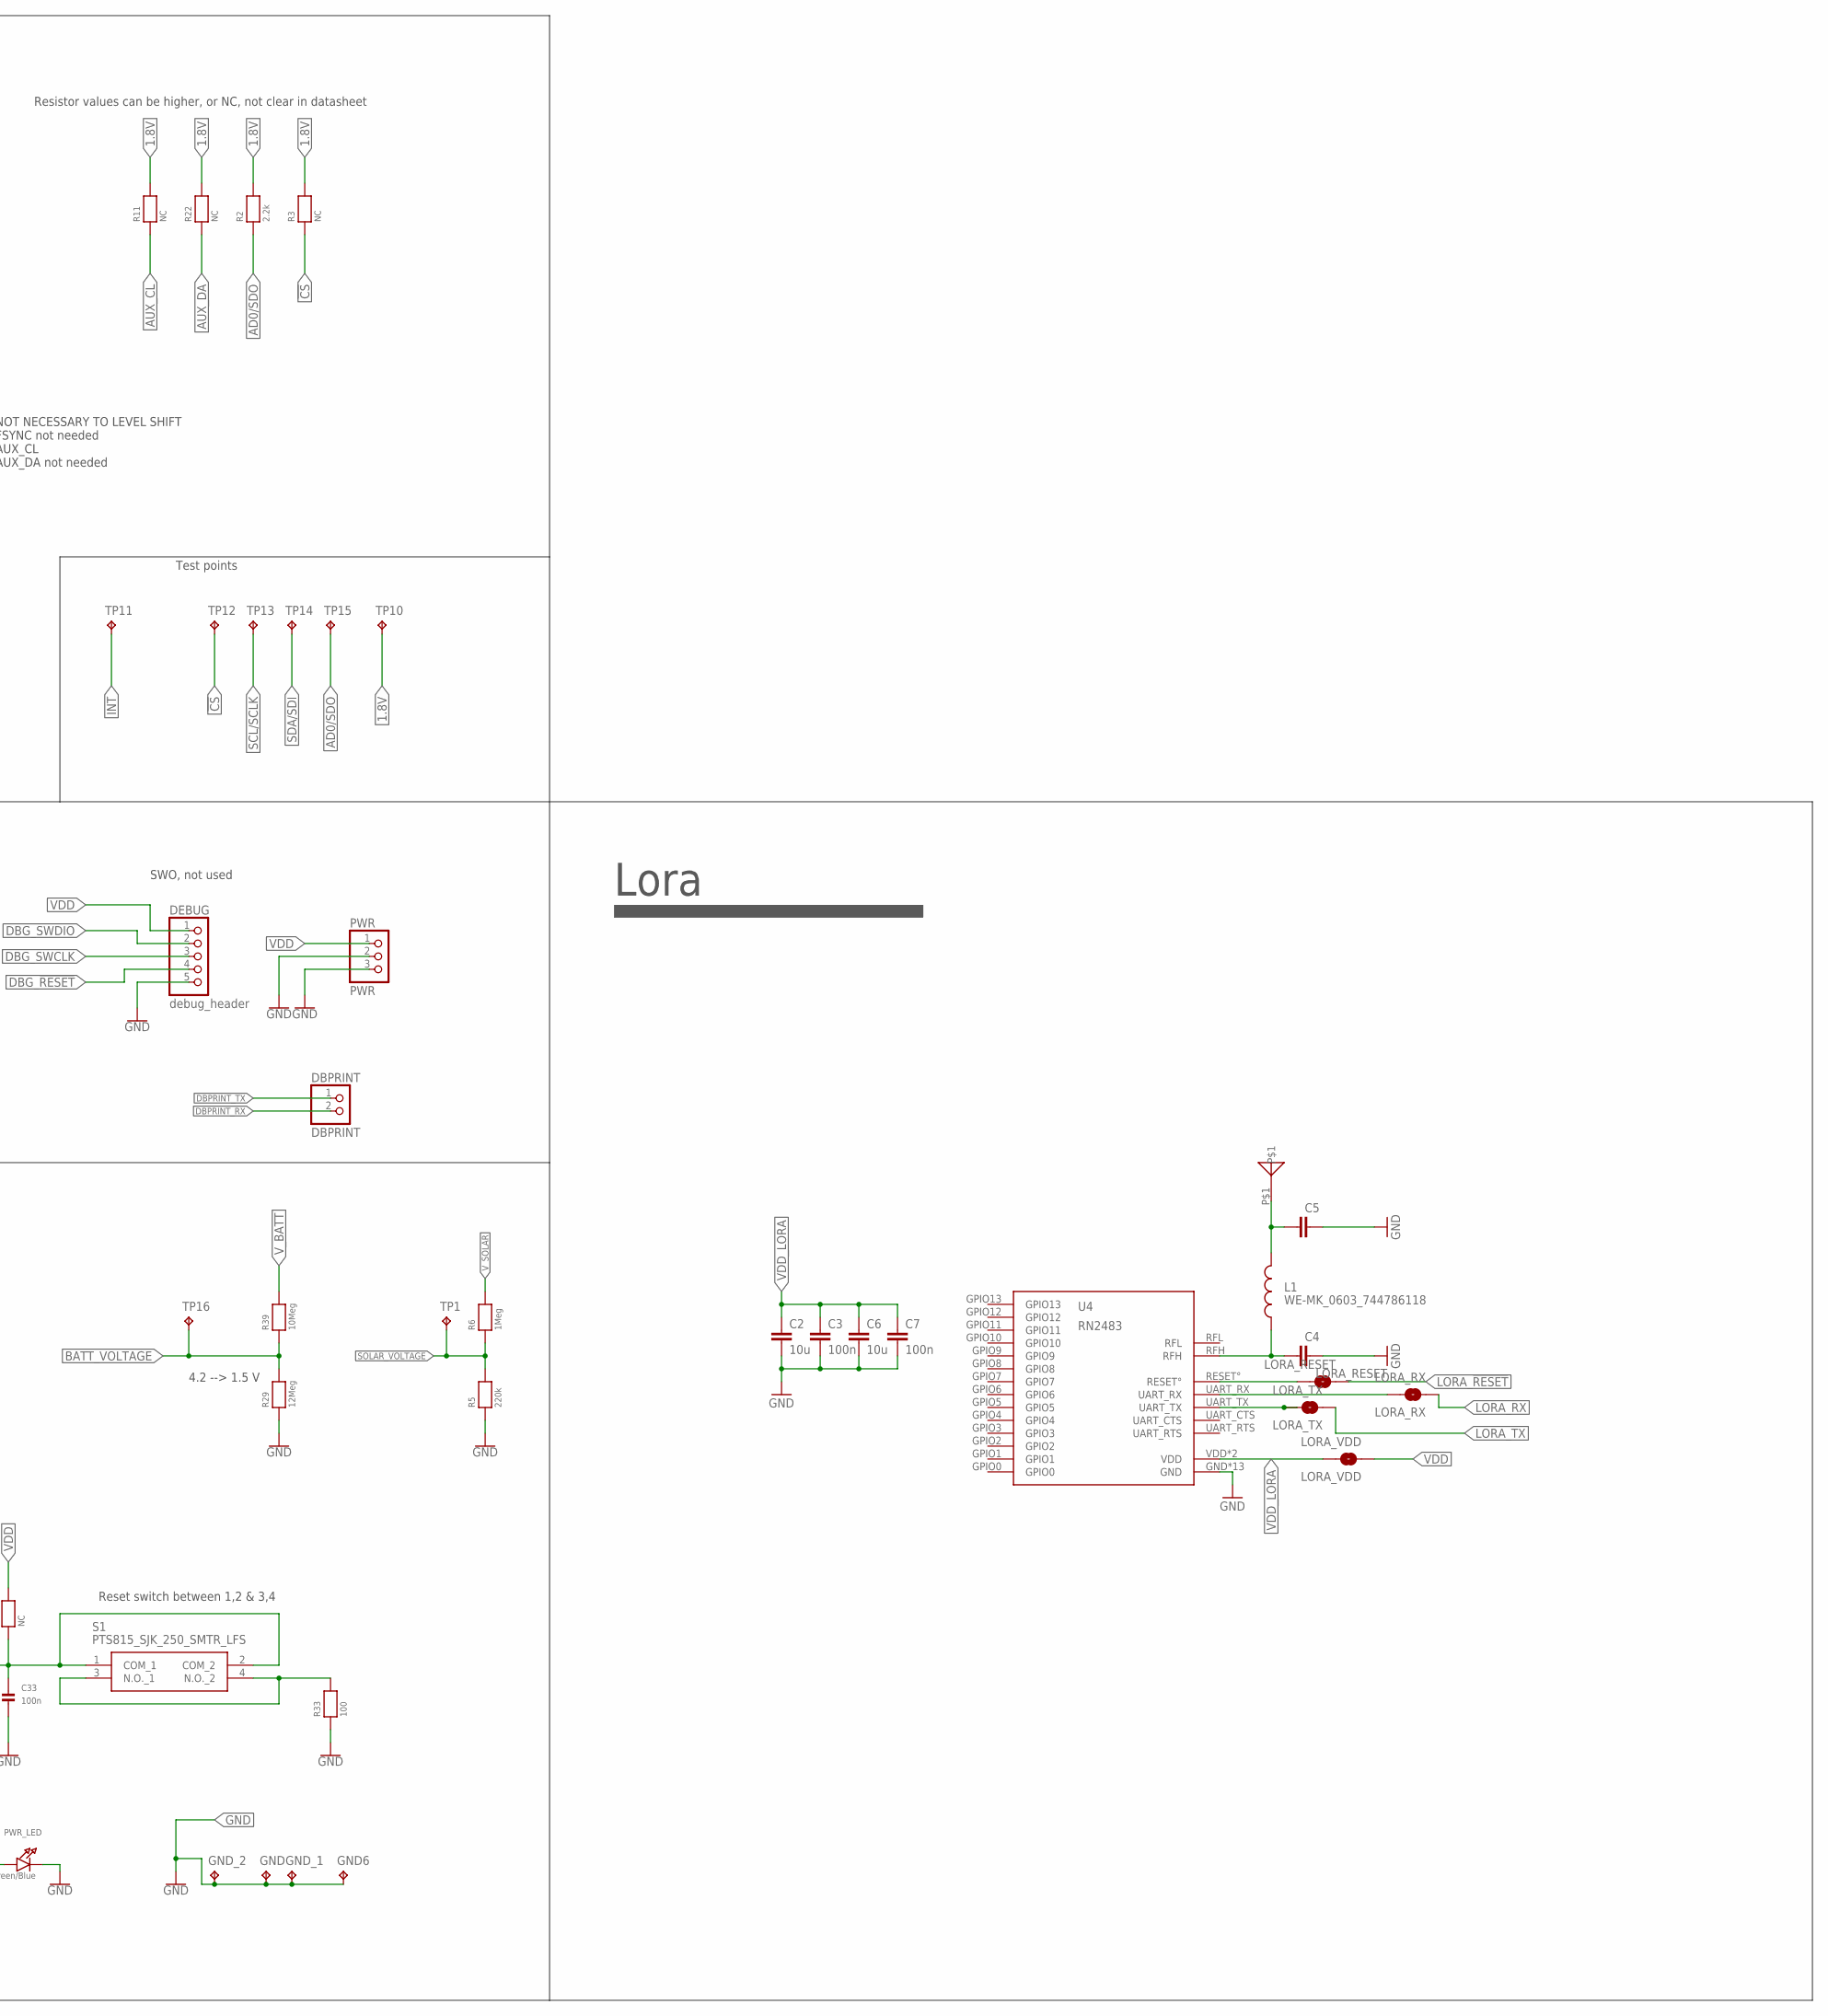
[picture p84: schematic Embedded_II_MAIN_BOARD.sch, part in row 1, column 2]

Parts:
7SEG/I2C: 7SEG/I2C; 1X02
ADDR: ADR; SMT-JUMPER_2_NO_SILK
ANALOG: ANALOG; 1X02
BATT_V: BATT_V; SMT-JUMPER_2_NO_SILK
BUTTON: BUTTON; 1X01
C1, C24, C25: 10u; 0603
C2, C6: 10u; C0805K
C3, C7: 100n; C0805K
C4, C5: C-EUC0603K; C0603K
C21, C32, C38, C41: 1u; 0603
C22, C23, C26, C27, C28, C29, C33: 100n; 0603
C30, C31: 10n; 0603
C34, C35: 18p; 0603
C36, C37: 12p; 0603
DBG_OPT: DBG_OPT; 1X02
DBPRINT: DBPRINT; 1X02
DEBUG: debug_header; 1X05
EXTRA: EXTRA; 1X04
EXTRA1: EXTRA; 1X02
FB1: 74279266; BEADC1608X100N
GND, GND6: TPTP20SQ; TP20SQ
GND_1, GND_2: TPTP20SQ; TP20SQ
IC2: EFM32HG322F64G-C-QFP48R; QFP50P900X900X120-48N
IC5: TPS7A0518PDBZR; SOT95P237X112-3N
IMU: IMU; SMT-JUMPER_2_NO_SILK
IMU_I2C: IMU_I2C; 1X02
L1: WE-MK_0603_744786118; WE-MK_0603
LED: LED; SMT-JUMPER_2_NO_SILK
LEDS: LEDS; 1X04
LORA_RESET: LORA_RESET; SMT-JUMPER_2_NO_SILK
LORA_RX: LORA_RX; SMT-JUMPER_2_NO_SILK
LORA_TX: LORA_TX; SMT-JUMPER_2_NO_SILK
LORA_VDD: LORA_VDD; SMT-JUMPER_2_NO_SILK
PF0: PF0; SMT-JUMPER_2_NO_SILK
PF1: PF1; SMT-JUMPER_2_NO_SILK
PWR: PWR; 1X03
PWR_LED: Green/Blue; CHIPLED_0805
Q1, Q6, Q8: 20V/0.2A/8MHz/1.2Ω/1Vth; SOT-416FL
R1: 120; 0603
R2, R15, R18, R19, R20, R21, R23: 2.2k; 0603
R3, R11, R22, R32: NC; 0603
R4, R7, R8, R9, R10: 10k; 0603
R5: 220k; 0603
R6: 1Meg; 0603
R29: 12Meg; 0603
R33: 100; 0603
R34: 1; 0603
R39: 10Meg; 0603
RFID/SPI: RFID / SPI; 1X04
RX: RX; SMT-JUMPER_2_NO_SILK
S1: PTS815_SJK_250_SMTR_LFS; PTS815SJK250SMTRLFS
SCL: SCL; SMT-JUMPER_2_NO_SILK
SDA: SDA; SMT-JUMPER_2_NO_SILK
SOLAR_V: SOLAR_V; SMT-JUMPER_2_NO_SILK
TP1, TP2, TP7, TP8, TP9, TP10, TP11, TP12, TP13, TP14, TP15, TP16, TP17, TP18, TP19: TPTP10R; TP10R
TX: TX; SMT-JUMPER_2_NO_SILK
TX/RX_OPT: TX/RX_OPT; 1X02
U3: 9DoF IMU; SPARKFUN-SENSORS_QFN24-3X3
U4: RN2483
U$2: ANTENNA868; CERAMIC-ANTENNA
Y2: FC-135_32.7680KA-A3; FC135327680KAAG0
Y3: ABM3B-24.000MHZ-B2-T; ABM3B8000MHZ101UT

Connections:
1.8V: C21.1, C22.1, C41.1, IC5.2 (OUT), Q1.1 (G), Q6.1 (G), Q8.1 (G), R2.2, R3.2, R11.2, R15.2, R18.2, R20.2, R22.2, TP10.TP, U3.8 (VDDIO), U3.13 (VDD)
!CS: R3.1, TP12.TP, U3.22 (!CS)
!CS!_RFID: IC2.30 (PC8), RFID/SPI.4
AD0/SDO: ADDR.2, R2.1, TP15.TP, U3.9 (AD0/SDO)
AUX_CL: R11.1, U3.7 (AUX_CL)
AUX_DA: R22.1, U3.21 (AUX_DA)
AVDD: C24.1, C30.1, C31.1, IC2.19 (AVDD_1), IC2.23 (AVDD_0), R34.2
BATT_VOLTAGE: BATT_V.1, R29.2, R39.1, TP16.TP
DBG_!RESET: C33.1, DEBUG.4, IC2.16 (RESETN), R32.1, S1.1 (COM_1), S1.2 (COM_2), TP9.TP
DBG_SWCLK: DEBUG.3, IC2.37 (PF0), PF0.2
DBG_SWDIO: DEBUG.2, IC2.38 (PF1), PF1.2
DBPRINT_RX: DBPRINT.2, RX.2
DBPRINT_TX: DBPRINT.1, TX.1
DECOUPLE: C32.1, IC2.29 (DECOUPLE)
GND: ADDR.1, C1.2, C2.2, C3.2, C4.1, C5.1, C6.2, C7.2, C21.2, C22.2, C23.2, C24.2, C25.2, C26.2, C27.2, C28.2, C29.2, C30.2, C31.2, C32.2, C33.2, C34.2, C35.2, C36.2, C37.2, C38.2, C41.2, DEBUG.5, GND.TP, GND6.TP, GND_1.TP, GND_2.TP, IC2.5 (VSS_1), IC2.18 (VSS_2), IC2.44 (VSS_3), IC5.1 (GND), PWR.2, PWR.3, PWR_LED.C, R5.1, R29.1, R33.1, U3.18 (GND), U3.20 (GND), U4.GND, U4.GND1 (GND), U4.GND2 (GND), U4.GND3 (GND), U4.GND4 (GND), U4.GND5 (GND), U4.GND6 (GND), U4.GND7 (GND), U4.GND8 (GND), U4.GND9 (GND), U4.GND10 (GND), U4.GND11 (GND), U4.GND12 (GND), Y3.2 (GND_1), Y3.4 (GND_2)
IMU_VDD: C1.1, C38.1, IC5.3 (IN), IMU.1, TP17.TP
IMU_VDD_PIN: IC2.41 (PF4), IMU.2
INT: Q1.2 (S), R15.1, TP11.TP, U3.12 (INT)
INT_VIN: IC2.8 (PC2), Q1.3 (D), R23.1
LED: LED.1, R1.1, TP2.TP
LORA_!RESET!: IC2.15 (PA10), LORA_RESET.1
LORA_RX: IC2.24 (PD4), LORA_RX.1, TP19.TP
LORA_TX: IC2.25 (PD5), LORA_TX.1, TP18.TP
unnamed: C5.2, L1.2, U$2.P$1
unnamed: C4.2, L1.1, U4.RFH
unnamed: PWR_LED.A, R1.2
unnamed: IC2.32 (PC10), LED.2
unnamed: LORA_RX.2, U4.UART_RX
unnamed: LORA_TX.2, U4.UART_TX
unnamed: LORA_RESET.2, U4.RESET°
unnamed: C35.1, IC2.12 (PB8), Y2.2
unnamed: C23.1, U3.10 (REGOUT)
unnamed: C34.1, IC2.11 (PB7), Y2.1
unnamed: C37.1, IC2.20 (PB13), Y3.1
unnamed: C36.1, IC2.21 (PB14), Y3.3
unnamed: R33.2, S1.3 (N.O._1), S1.4 (N.O._2)
unnamed: FB1.2, R34.1
PA0: IC2.1 (PA0), RX.1, TX/RX_OPT.2
PA1: IC2.2 (PA1), LEDS.1
PA2: IC2.3 (PA2), LEDS.2
PA8: EXTRA1.1, IC2.13 (PA8)
PA9: EXTRA1.2, IC2.14 (PA9)
PB11: BUTTON.1, IC2.17 (PB11), R4.1
PC3: IC2.9 (PC3), LEDS.3
PC4: IC2.10 (PC4), LEDS.4
PC9: EXTRA.1, IC2.31 (PC9)
PD6: IC2.26 (PD6), SOLAR_V.2
PD7: BATT_V.2, IC2.27 (PD7)
PE10: IC2.45 (PE10), RFID/SPI.1
PE11: IC2.46 (PE11), RFID/SPI.2
PE12: IC2.47 (PE12), RFID/SPI.3
PE13: EXTRA.4, IC2.48 (PE13)
PF0: DBG_OPT.1, PF0.1
PF1: DBG_OPT.2, PF1.1
PF2: IC2.39 (PF2), TX.2, TX/RX_OPT.1
PF3: EXTRA.2, IC2.40 (PF3)
PF5: EXTRA.3, IC2.42 (PF5)
SCL: 7SEG/I2C.1, IC2.7 (PC1), IMU_I2C.1, R7.1, R9.1, SCL.2, TP8.TP
SCL/SCLK: Q6.2 (S), R18.1, TP13.TP, U3.23 (SCL/SCLK)
SCL/SCLK_VIN: Q6.3 (D), R19.1, SCL.1
SDA: 7SEG/I2C.2, IC2.6 (PC0), IMU_I2C.2, R8.1, R10.1, SDA.2, TP7.TP
SDA/SDI: Q8.2 (S), R20.1, TP14.TP, U3.24 (SDA/SDI)
SDA/SDI_VIN: Q8.3 (D), R21.1, SDA.1
SOLAR_VOLTAGE: R5.2, R6.1, SOLAR_V.1, TP1.TP
VDD: C25.1, C26.1, C27.1, C28.1, C29.1, DEBUG.1, FB1.1, IC2.4 (IOVDD_0), IC2.22 (IOVDD_3), IC2.28 (VDD_DREG), IC2.43 (IOVDD_5), LORA_VDD.1, PWR.1, R4.2, R7.2, R8.2, R9.2, R10.2, R19.2, R21.2, R23.2, R32.2
VDD_LORA: C2.1, C3.1, C6.1, C7.1, LORA_VDD.2, U4.VDD, U4.VDD2 (VDD)
V_BATT: ANALOG.2, R39.2
V_SOLAR: ANALOG.1, R6.2

Notes on the sheet:
IMU
Microcontroller
ADR -> I2C Address ------------------- open -> 0x69 closed -> 0x68 *Closing AD0 precludes SPI
VDD: 1.71 - 3.6 V VDDIO: 1.71 - 1.95 V
USB Connector
X5R!!!
Crystal 32.768kHz 12.5pF +-20ppm
HFXTAL 24MHZ 8pF +-20ppm
HFXTAL_P
HFXTAL_N
LFXTAL_P
LFXTAL_N
Reset switch between 1,2 & 3,4
Ferrite bead for better ADC performance
IOVDD_0 + VDD_DREG
IOVDD_0
IOVDD_3
IOVDD_5
Decoupling considerations: See AN0002.0: EFM32 and EZR32 Wireless MCU Series 0 Hardware Design Considerations
Pullup not necessary internal pullup on resetn pin
VDD: 1.98 - 3.8 V
Cin
Cout
PE13 can't be used as CS SPI
NOT NECESSARY TO LEVEL SHIFT FSYNC not needed AUX_CL AUX_DA not needed
MISO
MOSI
VDD_DREG
SWO, not used
Resistor values can be higher, or NC, not clear in datasheet
I2C Interface
Interrupt
Test points
Extra ontkoppeling
SPI RFID
GPIO
I2C 7SEGMENT
DBPRINT
DEBUG
4.2 --> 1.5 V
EXTRA PINNEN
IMU I2C
leds
SPI CS
Lora

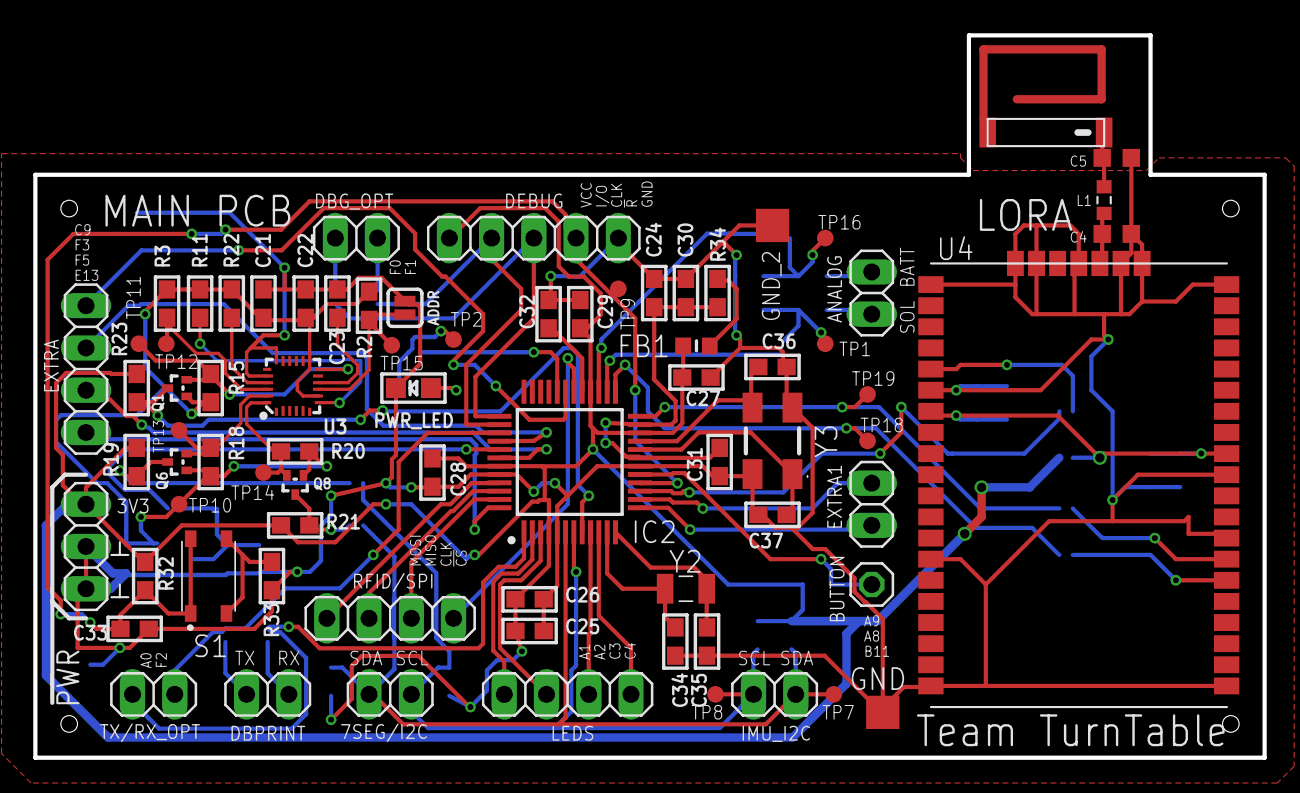
[picture p85: board Embedded_II_MAIN_BOARD.brd from above]

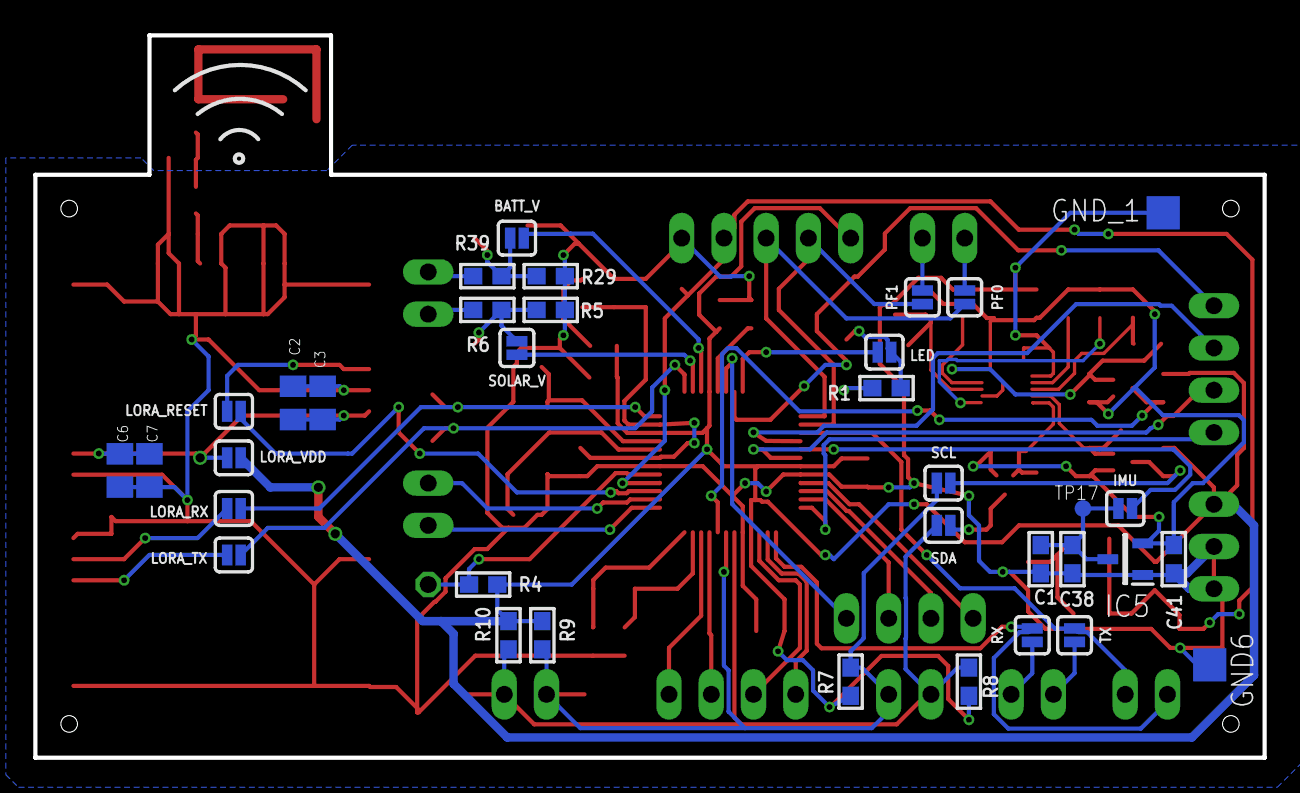
[picture p86: board Embedded_II_MAIN_BOARD.brd from below]

Board: 2 copper layers, 73.9 x 43.4 mm, 110 parts (35 on the bottom side), 68 nets.
