jonacappelle/Embedded-Systems-II-Lab/Jona - IMU and Main PCB/Embedded_II_ICM_20948/interrupt/interrupt.h

/*
 * interrupt.h
 *
 *  Created on: Nov 13, 2019
 *      Author: jonac
 */

#ifndef INTERRUPT_INTERRUPT_H_
#define INTERRUPT_INTERRUPT_H_


void initGPIO_interrupt(void);





#endif /* INTERRUPT_INTERRUPT_H_ */
