jonacappelle/Embedded-Systems-II-Lab/Jona - IMU and Main PCB/Embedded_II_ICM_20948/inc/util.h

/*
 * util.h
 *
 *  Created on: Mar 11, 2020
 *      Author: jonac
 */

#ifndef INC_UTIL_H_
#define INC_UTIL_H_

#include "stdint.h"
#include "stdbool.h"

bool Check_Equal(uint8_t *arr1, uint8_t *arr2, uint8_t length);

#endif /* INC_UTIL_H_ */
