jonacappelle/Embedded-Systems-II-Lab/(commit log)

2020-03-27 Hardware main board v0.1
    [Embedded_II_MAIN_BOARD.brd, Embedded_II_MAIN_BOARD.sch]
2020-03-27 pcb files + file pinnen
    [_saved_schema_pcb.sch, _saved_supercapLoader.sch, schema_pcb.kicad_pcb, schema_pcb.sch]
2020-03-27 start tekenen PCB
    [BatteryLoader.sch, EnergieBerekeningen.xlsx, _saved_schema_pcb.sch, _saved_supercapLoader.sch, schema_pcb.sch, supercapLoader.sch]
2020-03-29 schema getekend (bijna af), nog pcb routing
    [BatteryLoader.sch, schema_pcb.sch]
2020-03-30 schema getekend voeding_ bijna alle footprints volledig
    [BatteryLoader.sch, bq25505DesignSpreadsheet.xlsx, supercapLoader.sch]
2020-03-31 afgewerkte Energy Harvesting PCB
    [BatteryLoader.sch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]
2020-04-01 main board pcb
    [Embedded_II_MAIN_BOARD.brd, Embedded_II_MAIN_BOARD.sch]
2020-04-01 Routing main pcb
    [Embedded_II_MAIN_BOARD.brd, Embedded_II_MAIN_BOARD.sch]
2020-04-01 main pcb lora update, bijna klaar
    [Embedded_II_MAIN_BOARD.brd, Embedded_II_MAIN_BOARD.sch, v3.2.brd, v3.2.sch, v4.0.brd, v4.0.sch]
2020-04-01 renders voedings pcb
2020-04-02 finalisatie design main pcb (uC + imu + lora)
    [Embedded_II_MAIN_BOARD.GBL, Embedded_II_MAIN_BOARD.GBO, Embedded_II_MAIN_BOARD.GBP, Embedded_II_MAIN_BOARD.GBS, Embedded_II_MAIN_BOARD.GTL, Embedded_II_MAIN_BOARD.GTO, Embedded_II_MAIN_BOARD.GTP, Embedded_II_MAIN_BOARD.GTS]
2020-04-03 PCB's DONE! :100:
    [Embedded_II_MAIN_BOARD.brd, Embedded_II_MAIN_BOARD.sch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]
2020-04-17 update PCB + code + graphs
    [Embedded_II_MAIN_BOARD.sch, embedded.csv]
2020-04-17 update pcb + door te sturen info
    [Embedded_II_MAIN_BOARD.brd, Embedded_II_MAIN_BOARD.sch]
2020-05-02 Send player Id and Score via RN2483 Lora on EFM32
    Silicon Labs Export
    *Encode playerId and playerScore to RAW bytes
    *Send bytes via RN2483 lora module
    *EFM32 Happy Gecko development board
2020-05-06 Opmerkingen Tuur verbeterd, besluit nog schrijven!
    Alvast wat punten voor het besluit toegevoegd.
2020-05-07 Opkuis + sorteren
    [BOMfileCSV.csv, BatteryLoader.sch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]
